camerony/VoronCustom/v0.1_KirigamiLDOStealthFront/README.md

# Kirigami LDO Steath Bed Front V0.1

Based on MapleLeafMakers https://github.com/MapleLeafMakers/Stealth_Bed_Front

Used the Stealthburner toolhead diffuser https://github.com/VoronDesign/Voron-Stealthburner/blob/main/STLs/Stealthburner/%5Bc%5D_stealthburner_LED_diffuser.stl

Works only with the LDO Neopixel PCB

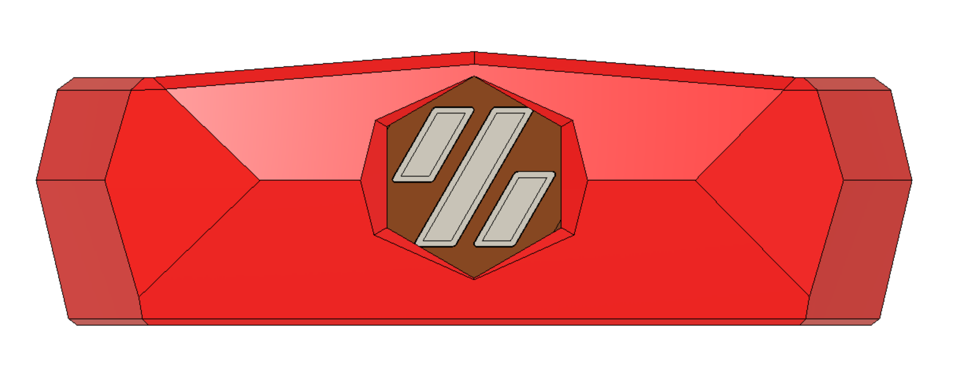
[picture p1: v0.1_KirigamiLDOStealthFront/images/front.png]
   
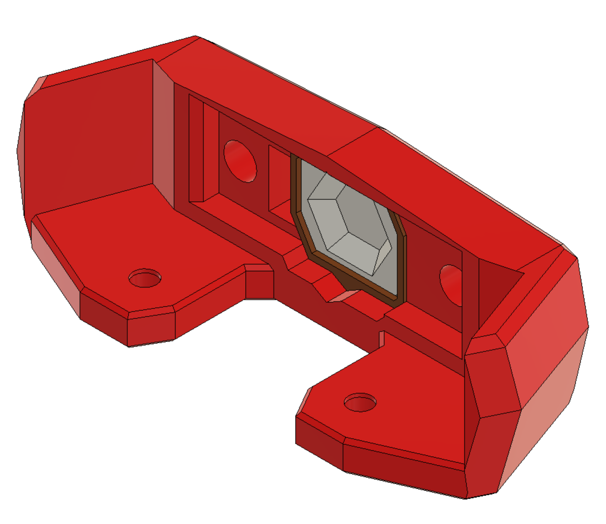
[picture p2: v0.1_KirigamiLDOStealthFront/images/back.png]
   

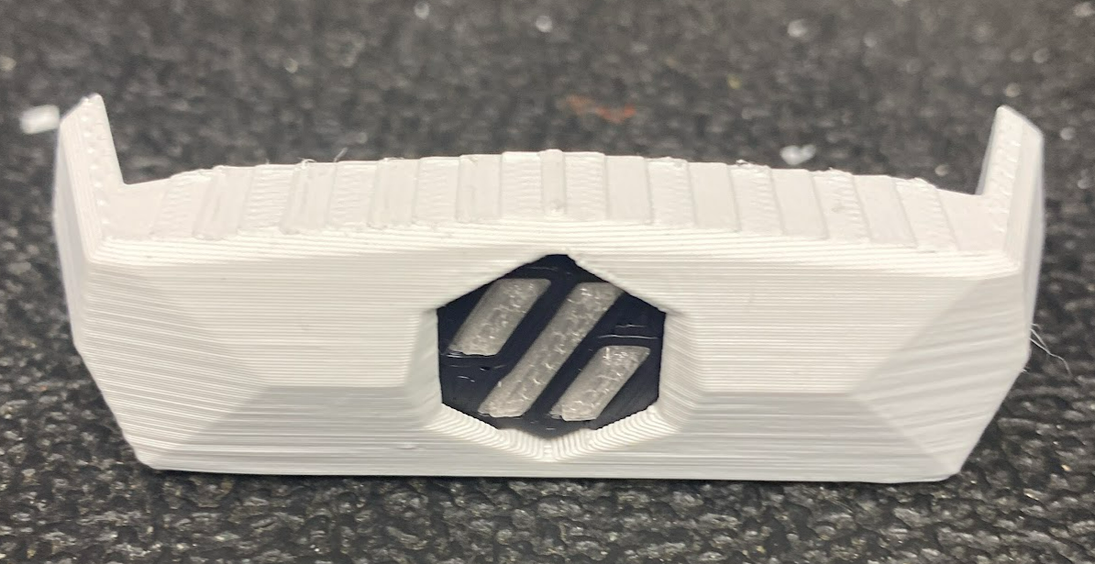
[picture p3: v0.1_KirigamiLDOStealthFront/images/print.png]
   
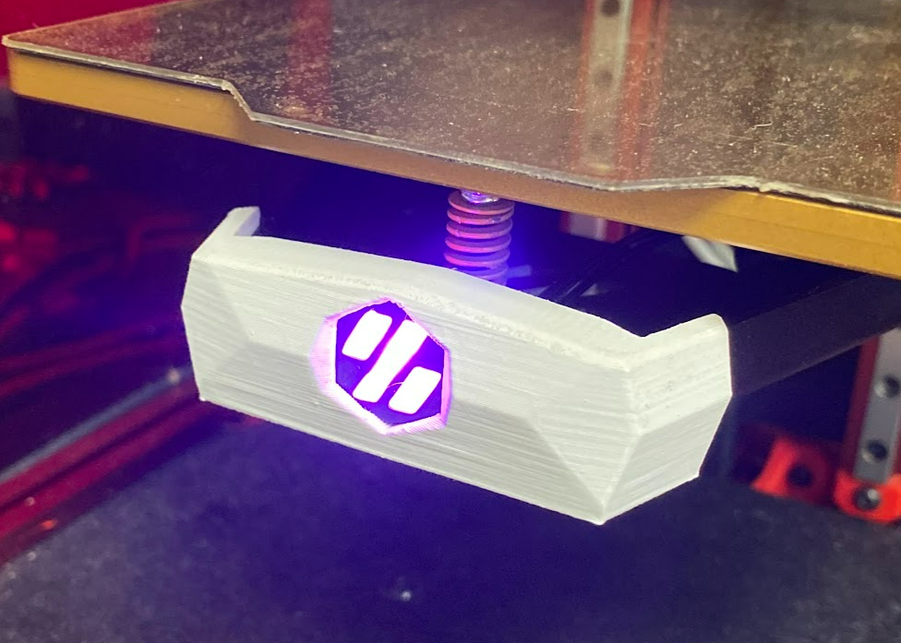
[picture p4: v0.1_KirigamiLDOStealthFront/images/installed.png]
