camerony/VoronCustom/v0.1_KirigamiCarriageSpacer/README.md

# Kirigami Bed Spacer V0.1

These spacers will allow you to reuse the original screws to mount the carriage to the Kirigami

8 x M2x8 SHCS

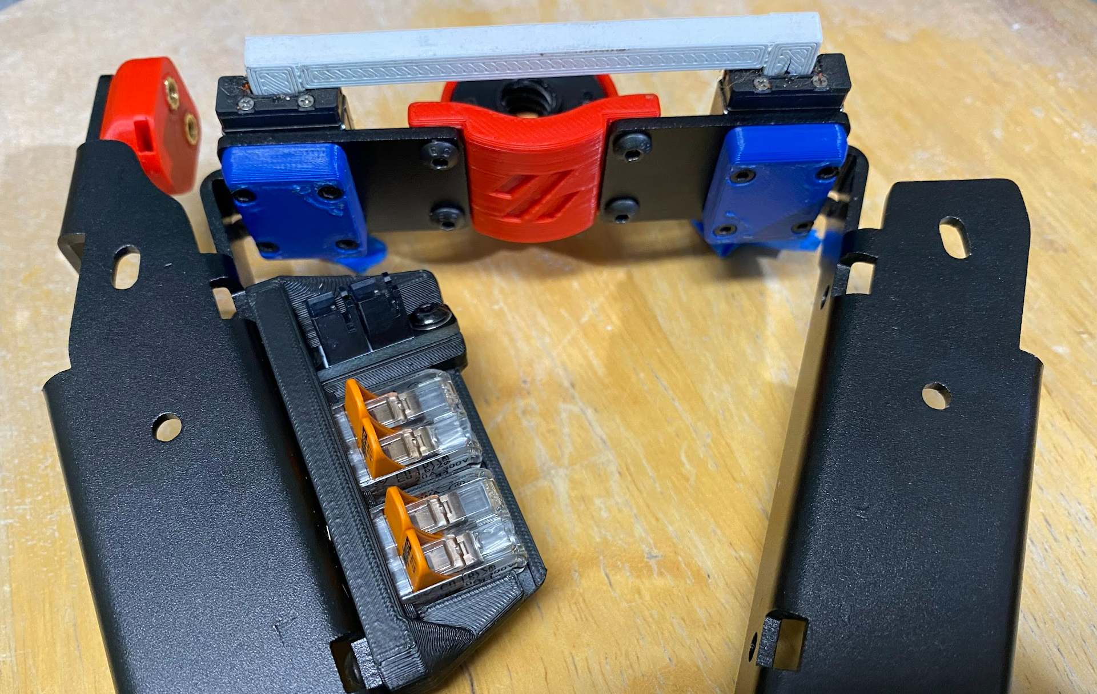
[picture p5: v0.1_KirigamiCarriageSpacer/images/installed.png]
