camerony/VoronCustom/V0.1_XY_Joint_Beefy/README.md

# XY Joint Extre Beef v0.1 (Beta)

.95mm of extra beef for the XY Joints

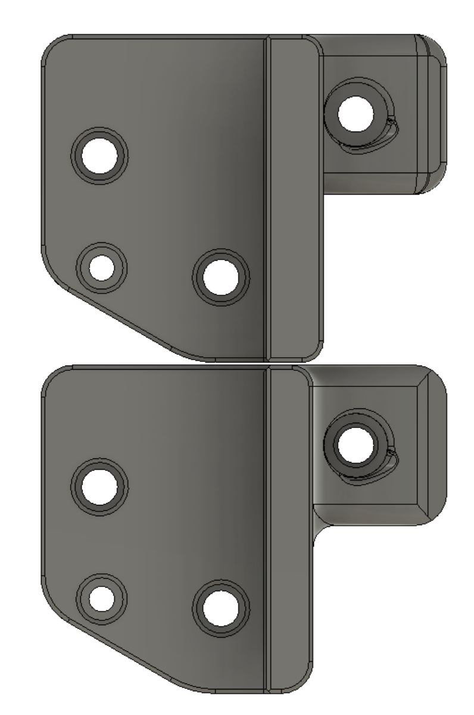
[picture p13: V0.1_XY_Joint_Beefy/images/cad.png]
