camerony/VoronCustom/v0.1_Tensioner_Knob_Indicator/README.md

# Tensioner Knob with Indicator v(Beta)

Makes it easier to get an even tension by having numbers on the tensioner knob.

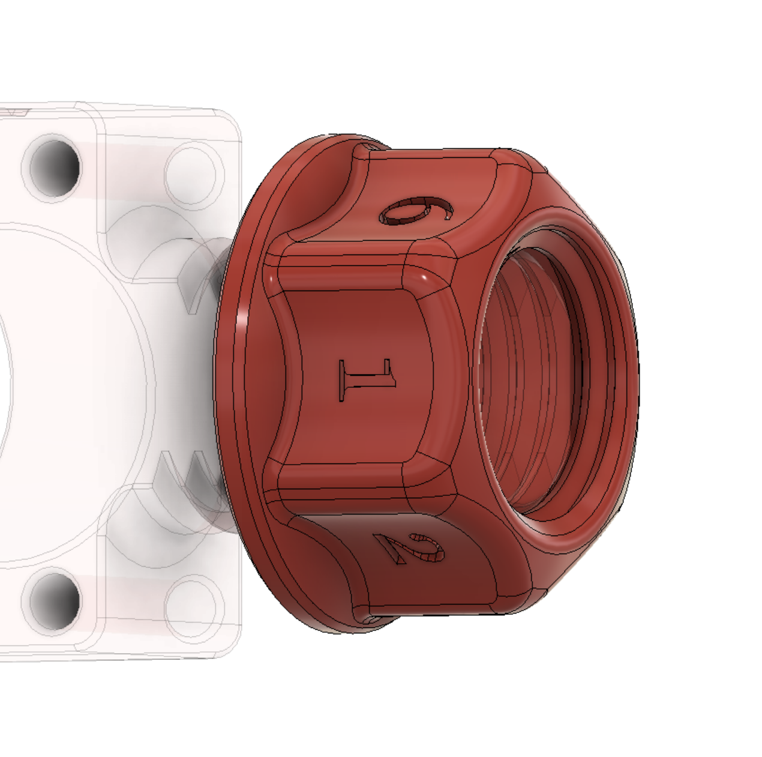
[picture p14: v0.1_Tensioner_Knob_Indicator/images/cad.png]
   
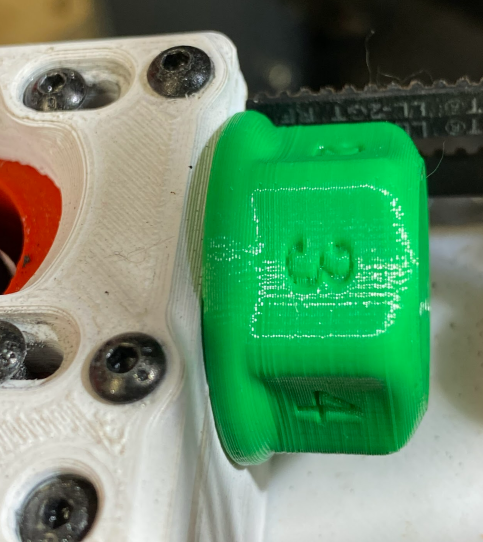
[picture p15: v0.1_Tensioner_Knob_Indicator/images/photo.png]
