camerony/VoronCustom/7x7CableChain/README.md

# 7x7 Cable Chain

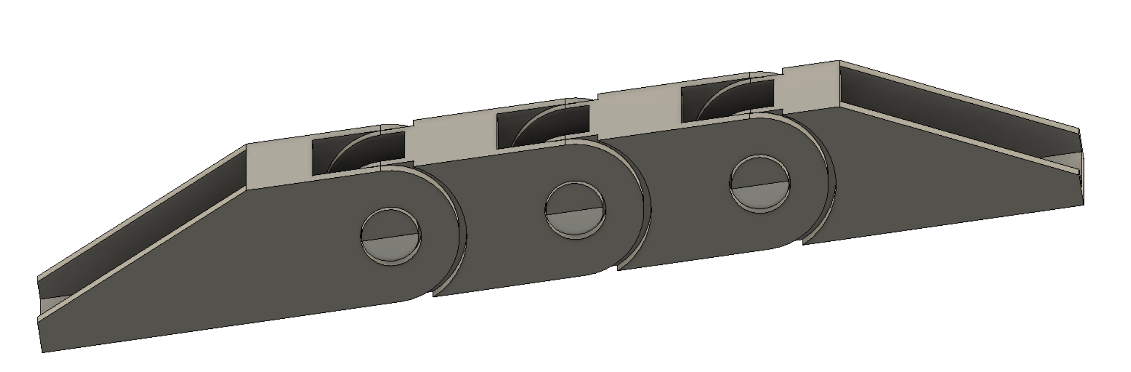
[picture p21: 7x7CableChain/images/cad.png]
   
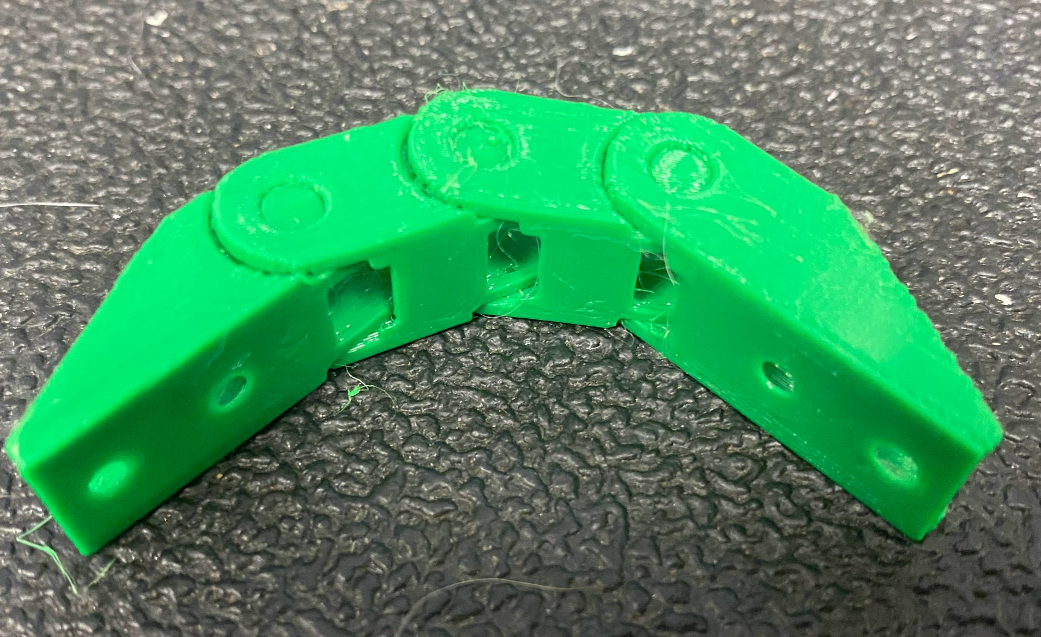
[picture p22: 7x7CableChain/images/photo.png]
   

Based on Cable Chain 7x7
by kespettakolo1973 https://www.thingiverse.com/thing:1867865
