camerony/VoronCustom/Plate_Nozzle_Probe/README.md

# Nozzy Probe : Plate Nozzle Probe for V0.1 (might work for others) ALPHA

MOVED TO V0.1_Nozzy_Probe
