camerony/VoronCustom/V0.1_Dual_X_Rail_Carriage/README.md

# Dual X Rail Carriage to V0.1

Add second rail to X-Axis to eliminate wobble

Requires:
1 x MGN7 rail (preferrable identical rail models)
4 x Machine Screw, FHCS, M2x6 (to attach carriage)
5 x M2x6 BHCS (mount rail to extrusion)
5 x M2 Nuts (mount rail to extrusion) or LDO rail mount

https://github.com/camerony/VoronCustom/blob/ebe7d462dfbc9d7f2f023d78ec90f3b2affd35e5/V0.1_Raise_X_Axis_Extrusion_by_4mm

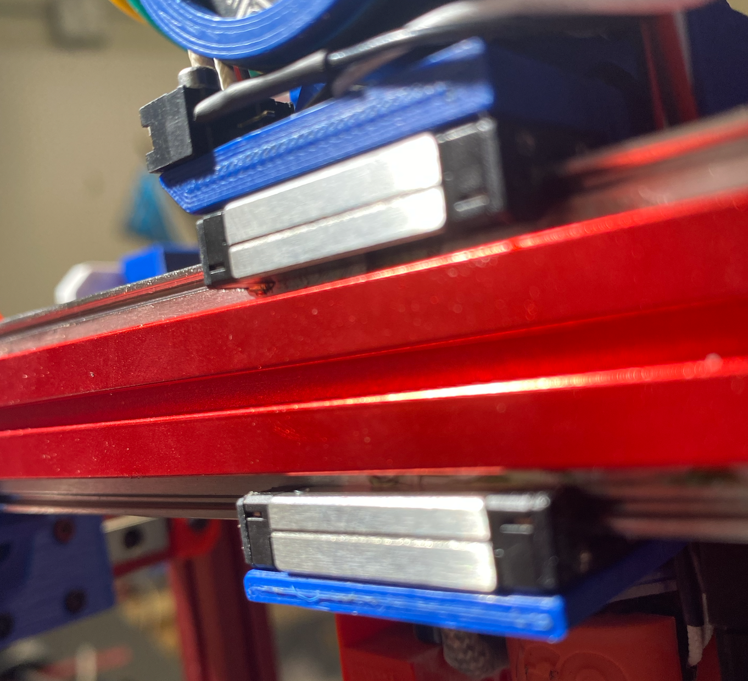
[picture p34: V0.1_Dual_X_Rail_Carriage/images/installed.png]

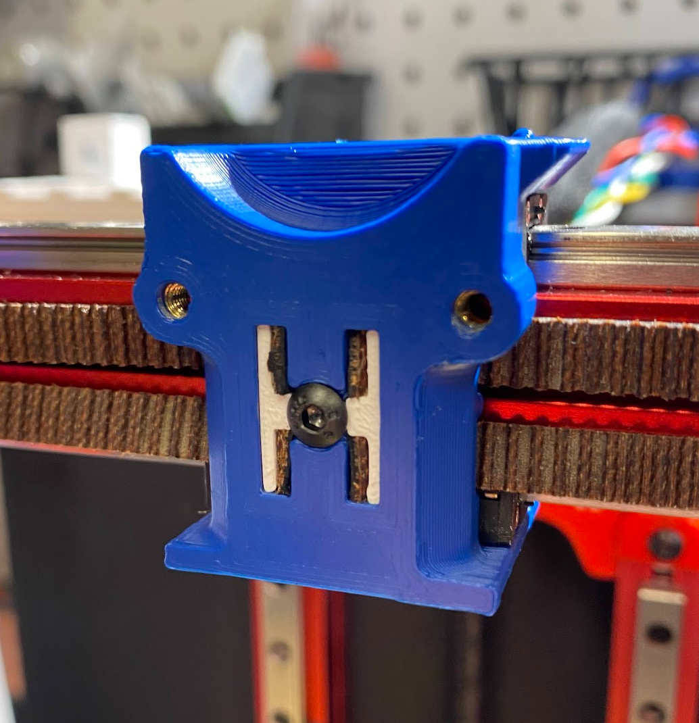
[picture p35: V0.1_Dual_X_Rail_Carriage/images/installeddualx.png]
