camerony/VoronCustom/V0.1_Raise_X_Axis_Extrusion_by_4mm/README.md

# Raise X-Axis Extrusion Clearance by 4mm

Adds 4mm clearance between X-Axis extrusion and Z-Axis extrusions.

Usage will allow for second X rail to be mounted underneath.

Notes: Toolhead offset will change by 4 mm.  The toolhead must be lowered by 4mm to maintain Z toolhead offset or bed travel has to be raised by 4mm

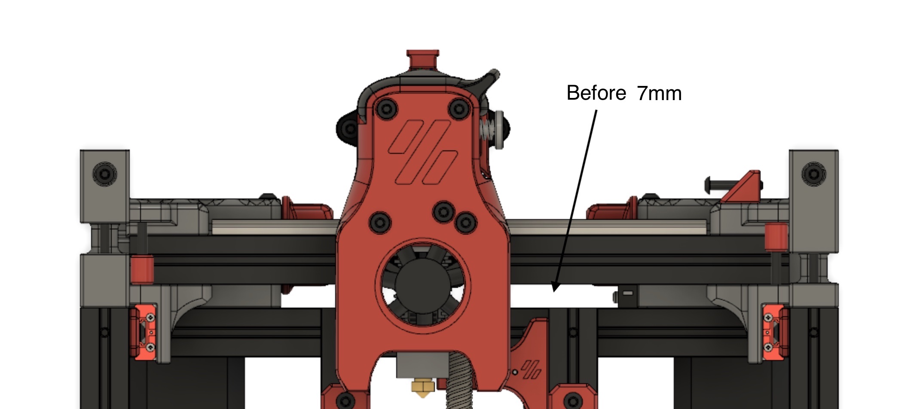
[picture p36: V0.1_Raise_X_Axis_Extrusion_by_4mm/images/before.jpg]

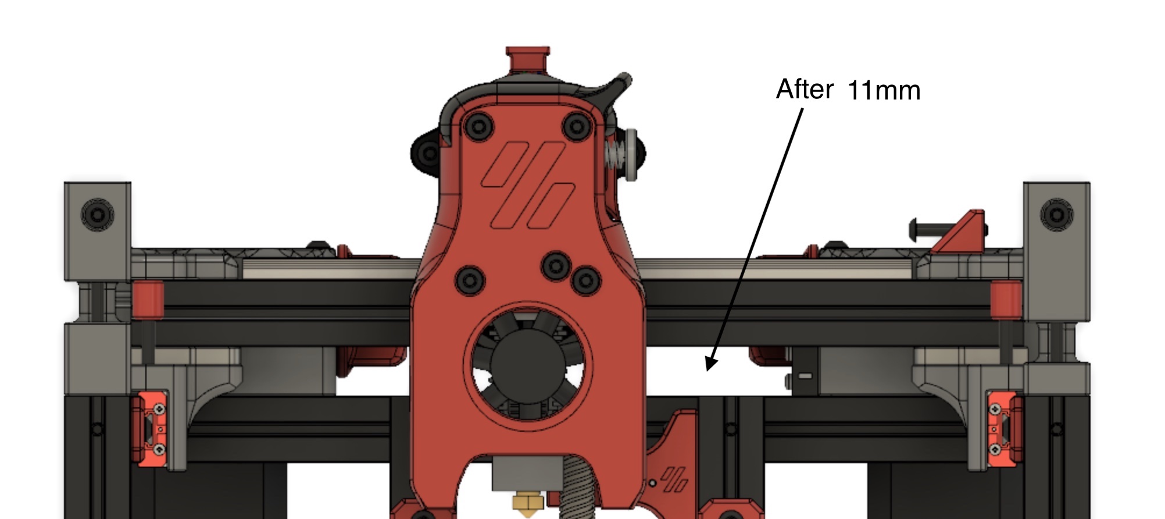
[picture p37: V0.1_Raise_X_Axis_Extrusion_by_4mm/images/after.jpg]
