camerony/VoronCustom/LDOSBCW2MountCover/images/IMG_20210709_141101.jpg

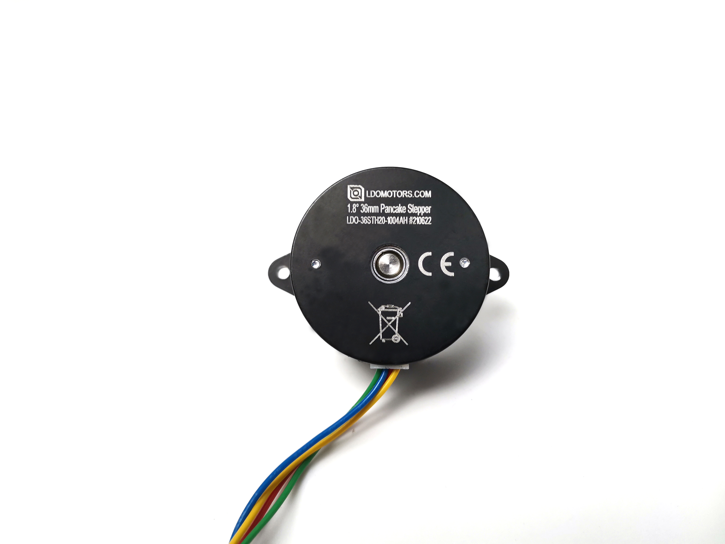
LDOSBCW2MountCover/images/IMG_20210709_141101.jpg
