camerony/VoronCustom/LDOSBCW2MountCover/images/LDO-36STH20-1004AHG(XH).png

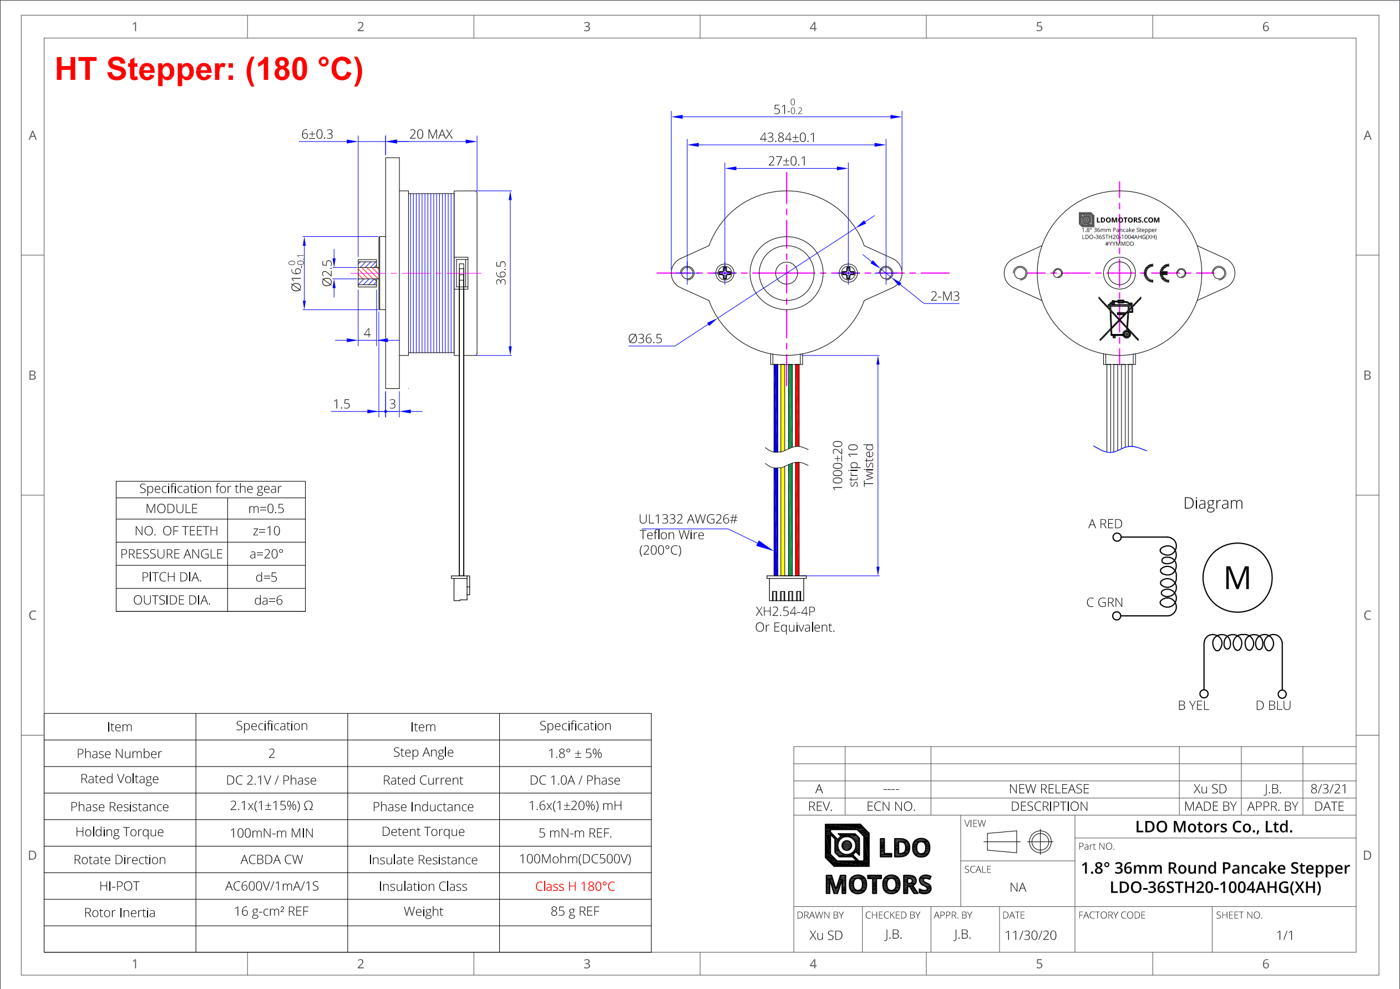
LDOSBCW2MountCover/images/LDO-36STH20-1004AHG(XH).png
