camerony/VoronCustom/LDOSBCW2MountCover/images/page1.png

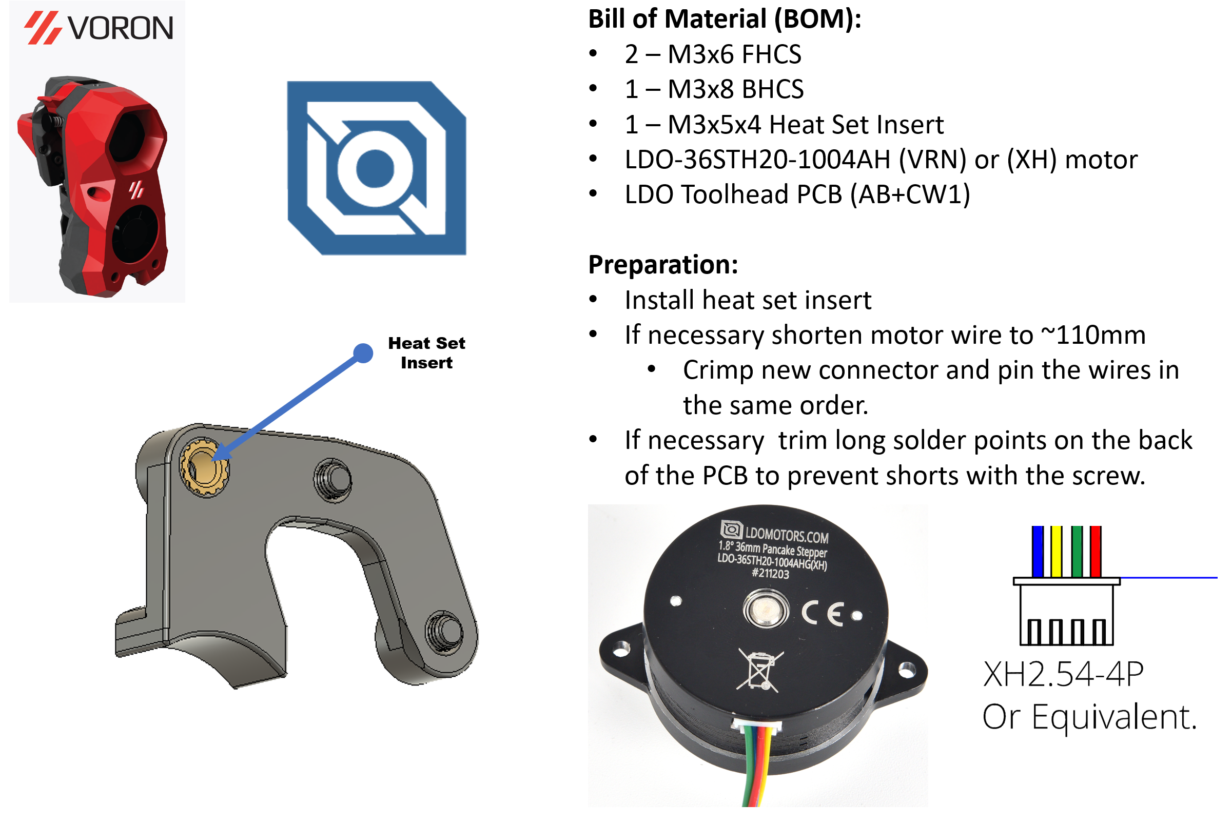
LDOSBCW2MountCover/images/page1.png
