camerony/VoronCustom/LDOSBCW2MountCover/images/SBCW2LDOPCB.png

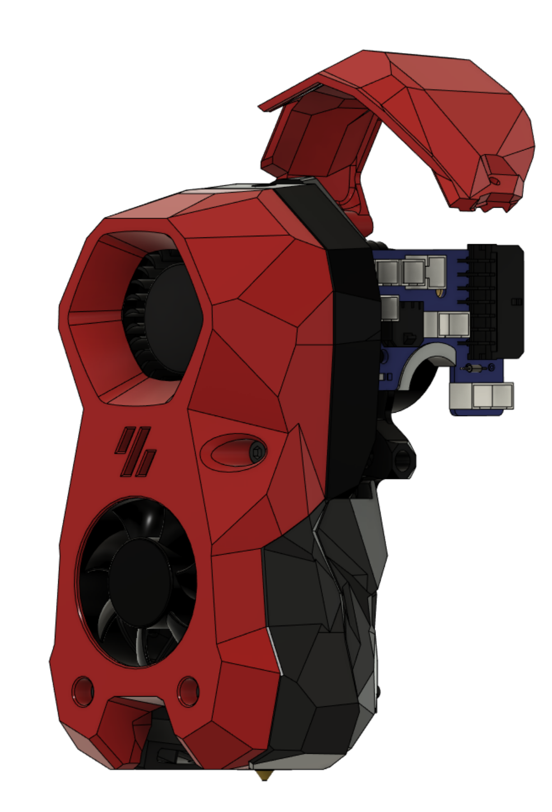
LDOSBCW2MountCover/images/SBCW2LDOPCB.png
