camerony/VoronCustom/V0.1_Display/images/cad2.png

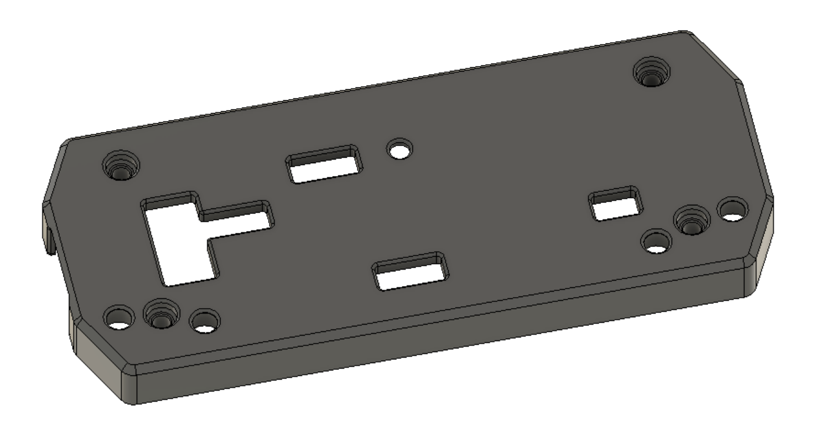
V0.1_Display/images/cad2.png
