camerony/VoronCustom/V0.1_Display/images/cad.png

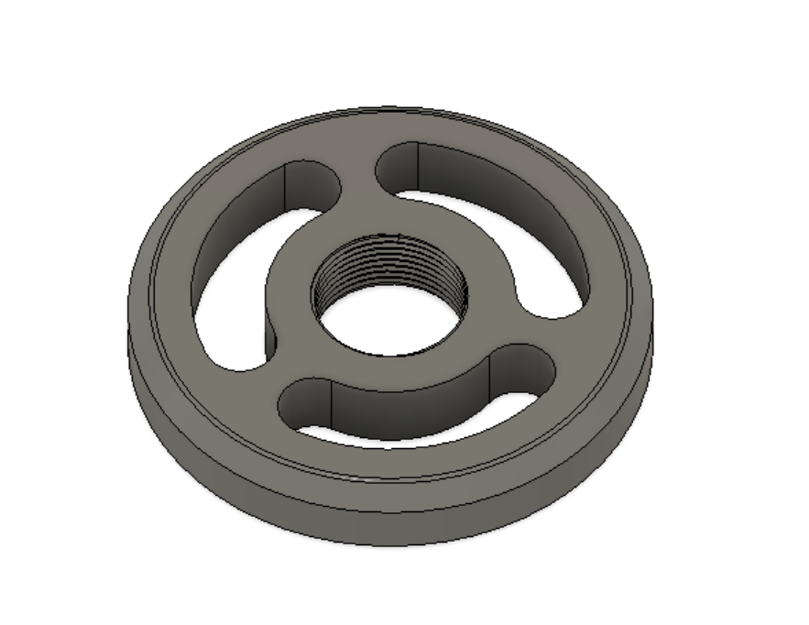
V0.1_Display/images/cad.png
