camerony/VoronCustom/V0.1_NoNut_X_Carriage/images/nut.png

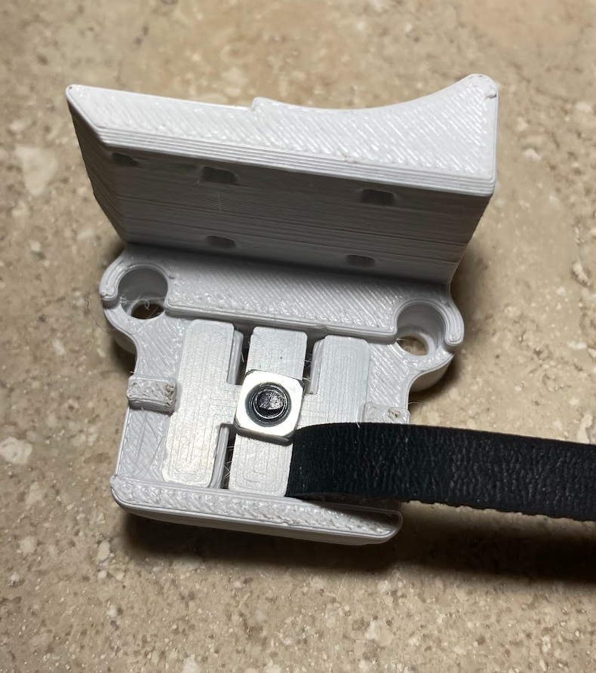
V0.1_NoNut_X_Carriage/images/nut.png
