camerony/VoronCustom/LDOPanels/LDODeckPanelFull.3mf

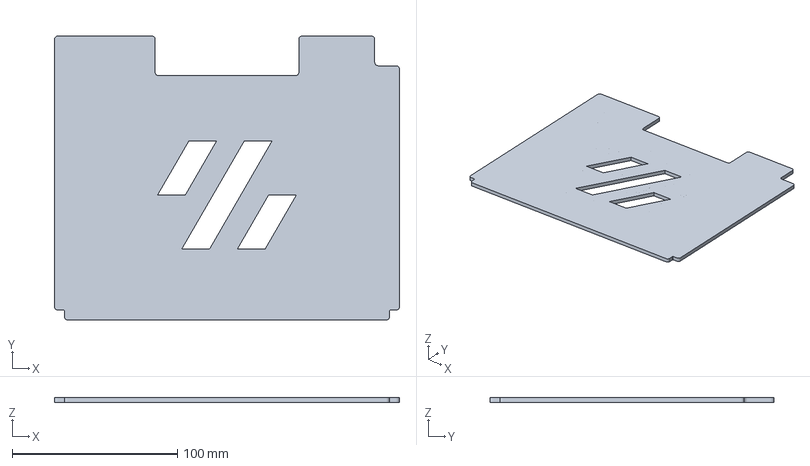
[picture p48: CAD file, 2022-01-04]
LDOPanels/LDODeckPanelFull.3mf
209.0 x 172.0 x 3.00 mm
