camerony/VoronCustom/3mmIdlers/3mmIdlers.stl

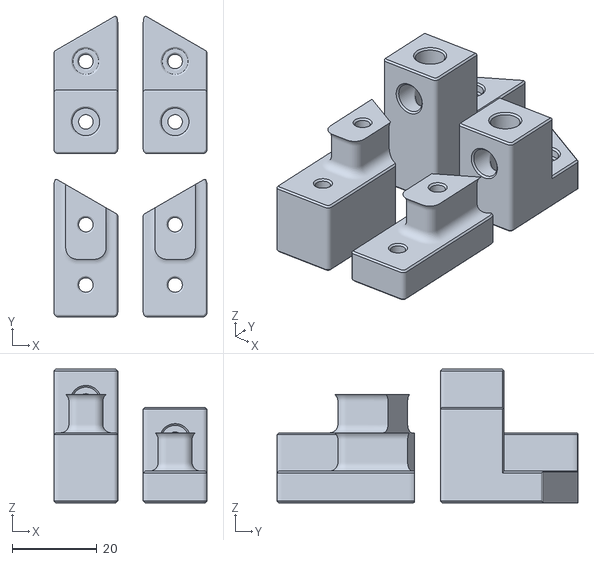
[picture p49: CAD file, 2022-01-26]
3mmIdlers/3mmIdlers.stl
36.0 x 70.8 x 31.5
