camerony/VoronCustom/7x7CableChain/7x7cablechain.step

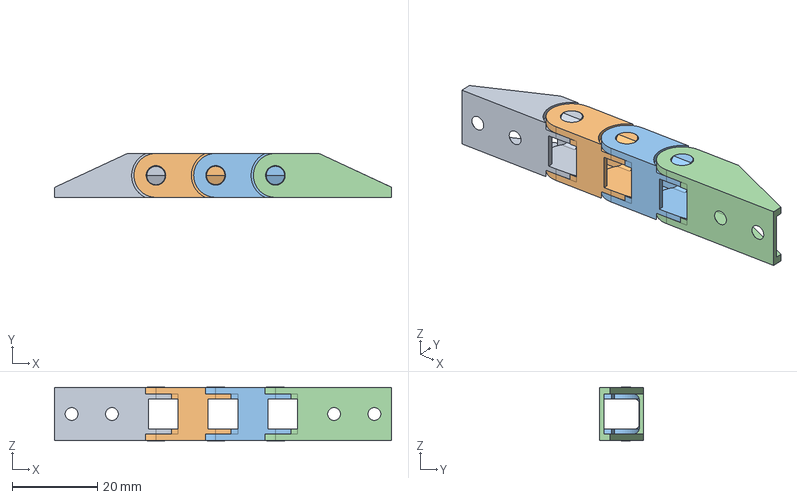
[picture p50: CAD file, 2022-03-20]
7x7CableChain/7x7cablechain.step
79.0 x 10.3 x 12.6 mm
7x7_end_male
7x7_cable_chain
7x7_cable_chain (1)
7x7_end_female
