camerony/VoronCustom/LDOPanels/LDOBackPanel.3mf

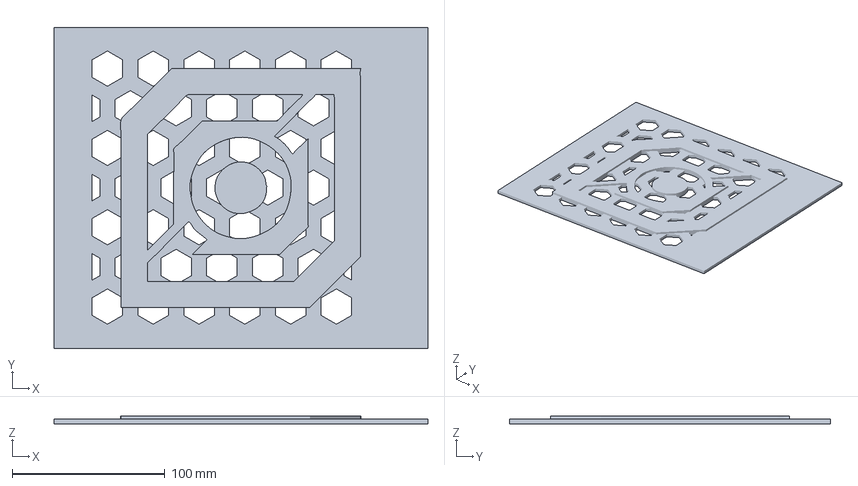
[picture p51: CAD file, 2022-01-04]
LDOPanels/LDOBackPanel.3mf
245.0 x 210.0 x 5.00 mm
