camerony/VoronCustom/LDOSBCW2MountCover/LDOSBCW2MountCover.3mf

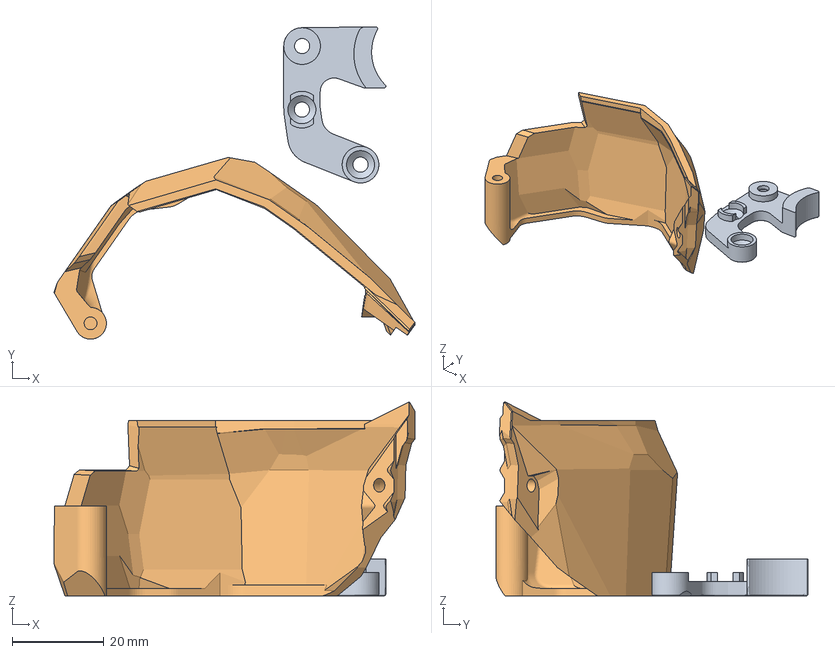
[picture p52: CAD file, 2022-08-19]
LDOSBCW2MountCover/LDOSBCW2MountCover.3mf
78.6 x 68.0 x 42.2 mm
