camerony/VoronCustom/LDOStrainRelief/VORON_CAD_V0.1_Strain_Relief_LDO_spacer_x2.3mf

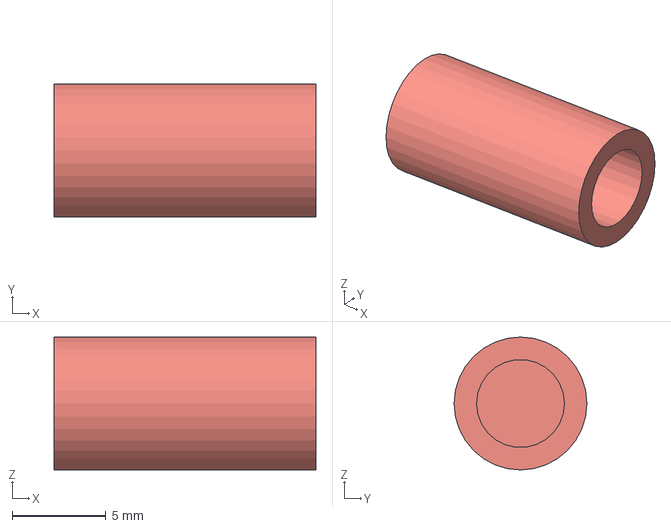
[picture p53: CAD file, 2021-11-27]
LDOStrainRelief/VORON_CAD_V0.1_Strain_Relief_LDO_spacer_x2.3mf
14.0 x 7.10 x 7.10 mm
