camerony/VoronCustom/MiniASLGXerpaLiteMount/MiniASLGXerpaLite-CoverV2.step

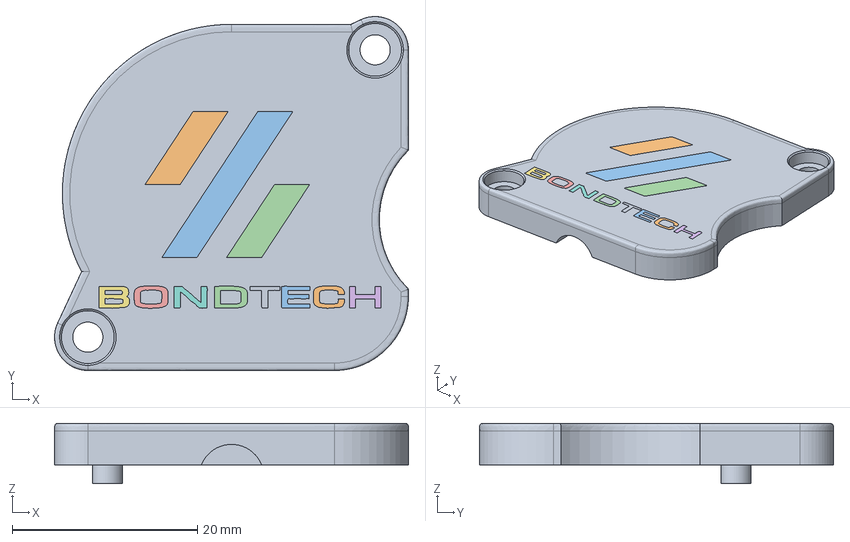
[picture p54: CAD file, 2022-03-21]
MiniASLGXerpaLiteMount/MiniASLGXerpaLite-CoverV2.step
38.2 x 38.2 x 6.50 mm
