camerony/VoronCustom/NeoPixelSolderingTool/NeoPixelSolderingTool.step

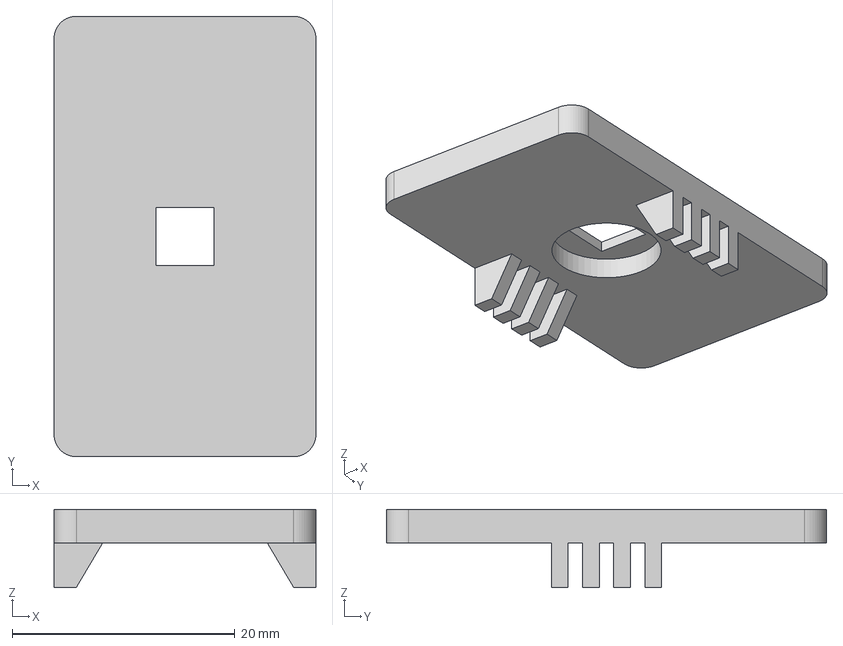
[picture p55: CAD file, 2022-04-14]
NeoPixelSolderingTool/NeoPixelSolderingTool.step
23.5 x 39.5 x 7.00 mm
