camerony/VoronCustom/Tuning/BeltTensionEqualizer/BeltTensionEqualizer.3mf

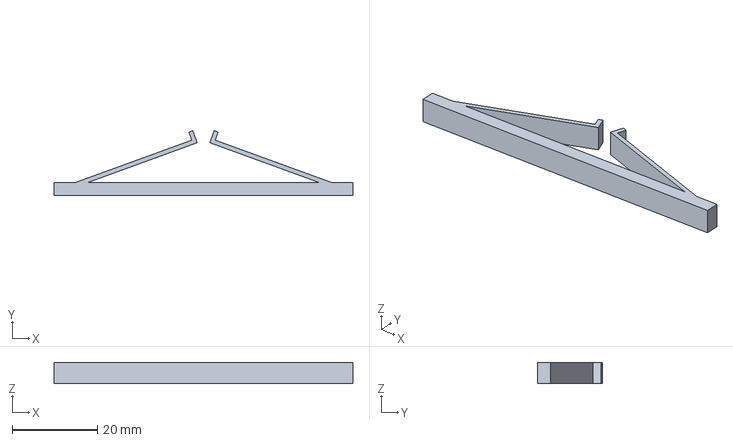
[picture p56: CAD file, 2022-01-04]
Tuning/BeltTensionEqualizer/BeltTensionEqualizer.3mf
70.0 x 15.1 x 5.00 mm
