camerony/VoronCustom/Tuning/VFA/VFA_Model_SS_Thick.3mf

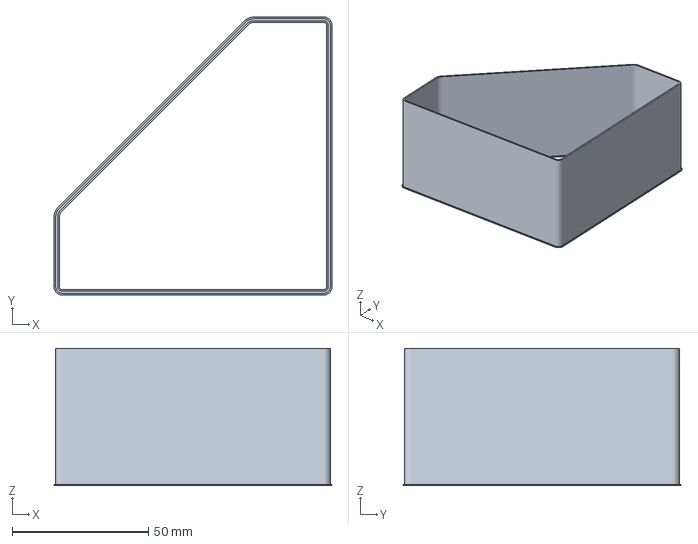
[picture p57: CAD file, 2022-03-28]
Tuning/VFA/VFA_Model_SS_Thick.3mf
102.0 x 102.0 x 50.3 mm
