camerony/VoronCustom/V0.1_BedTransfer/V0.1_bed_transfer.step

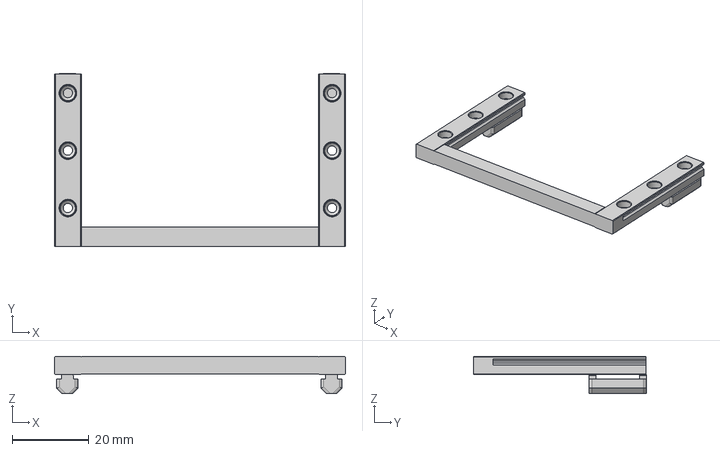
[picture p58: CAD file, 2022-03-06]
V0.1_BedTransfer/V0.1_bed_transfer.step
76.0 x 45.1 x 9.79 mm
