camerony/VoronCustom/V0.1_Display/Housing_Rear_M2_10_x1.step

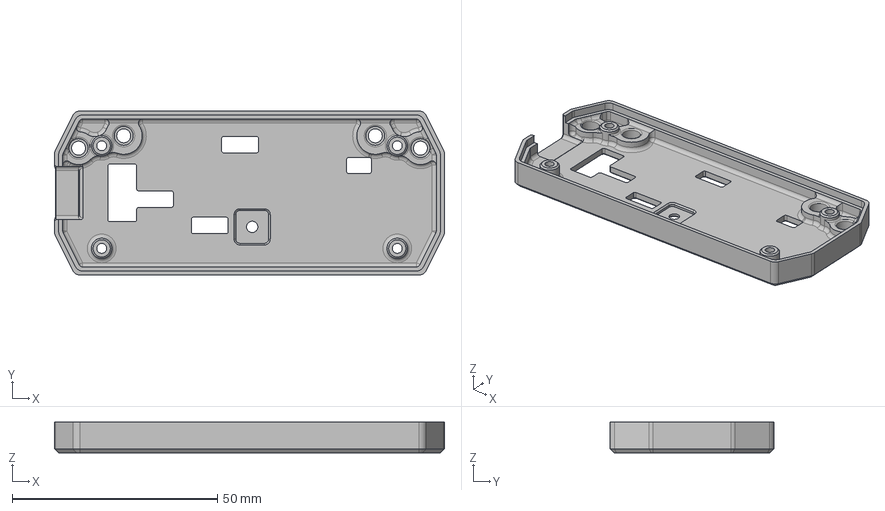
[picture p59: CAD file, 2022-04-21]
V0.1_Display/Housing_Rear_M2_10_x1.step
95.0 x 40.0 x 7.50 mm
