camerony/VoronCustom/V0.1_Dual_X_Rail_Carriage/standard_dual_x_carriage.stl

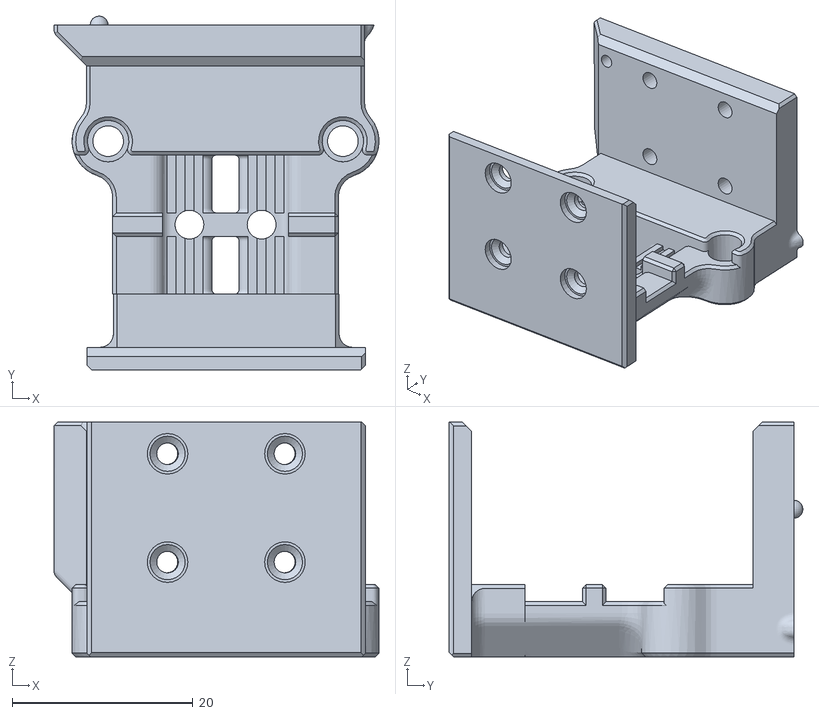
[picture p60: CAD file, 2022-01-28]
V0.1_Dual_X_Rail_Carriage/standard_dual_x_carriage.stl
36.0 x 39.2 x 26.0
