camerony/VoronCustom/v0.1_KirigamiCarriageSpacer/KirigamiCarriageSpacer_x2.3mf

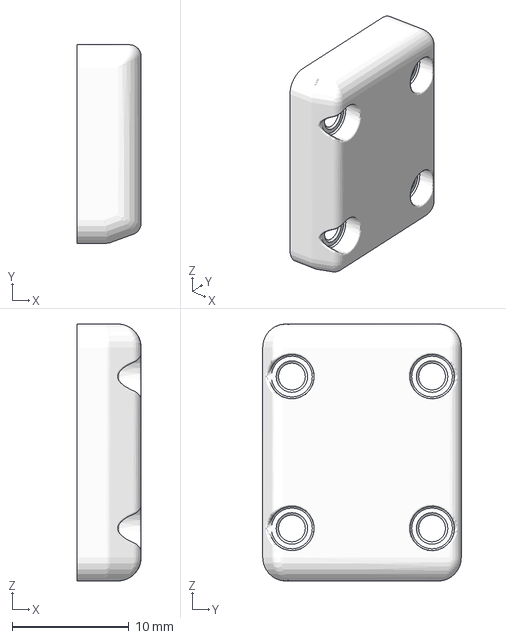
[picture p61: CAD file, 2022-05-16]
v0.1_KirigamiCarriageSpacer/KirigamiCarriageSpacer_x2.3mf
5.50 x 17.0 x 22.0 mm
