camerony/VoronCustom/v0.1_KirigamiLDOStealthFront/b_NeoPixel_Diffuser_Mask.stl

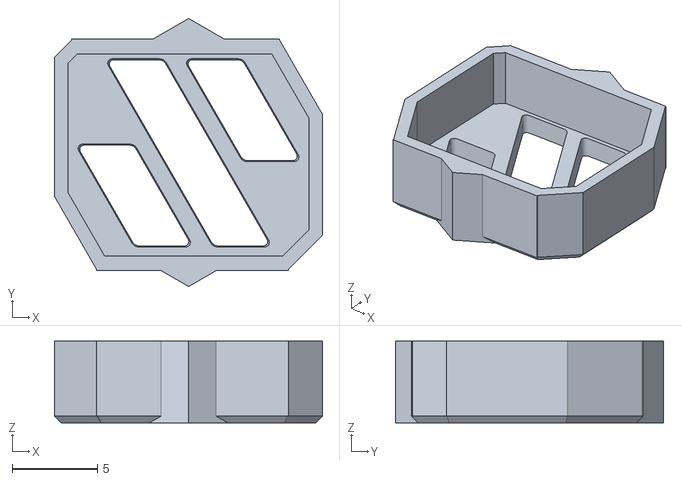
[picture p62: CAD file, 2022-09-03]
v0.1_KirigamiLDOStealthFront/b_NeoPixel_Diffuser_Mask.stl
15.7 x 15.7 x 4.80
