camerony/VoronCustom/v0.1_MiniAfterBlockHead/V2/hotendmountsV2/rapido_a.3mf

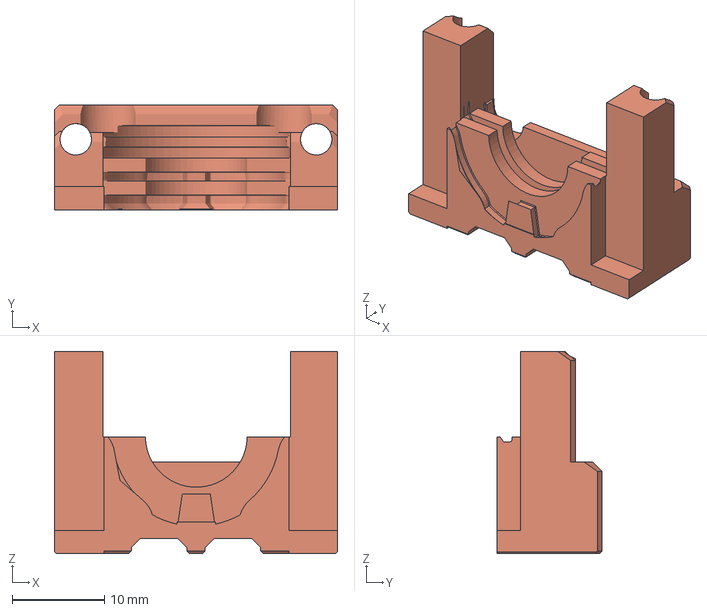
[picture p63: CAD file, 2022-04-21]
v0.1_MiniAfterBlockHead/V2/hotendmountsV2/rapido_a.3mf
30.6 x 11.4 x 21.9 mm
