camerony/VoronCustom/v0.1_MiniAfterBlockHead/V2/V01_MiniAfterBlockheadV2.3mf

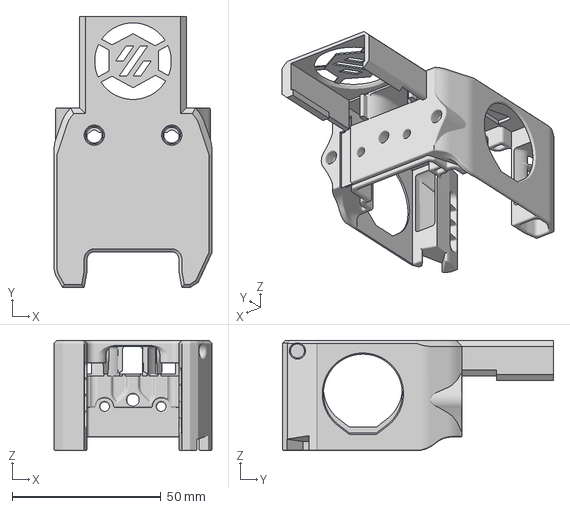
[picture p64: CAD file, 2022-04-21]
v0.1_MiniAfterBlockHead/V2/V01_MiniAfterBlockheadV2.3mf
53.0 x 91.0 x 37.0 mm
