camerony/VoronCustom/v0.1_MiniAfterBlockHead/X_Carriage_MGN9.step

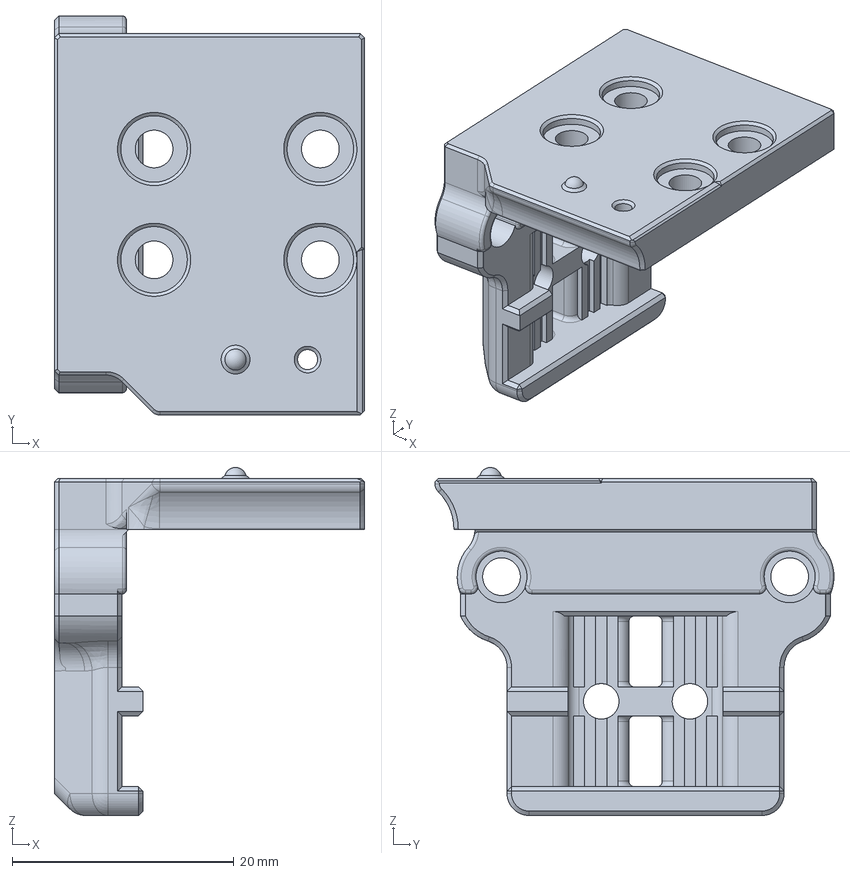
[picture p65: CAD file, 2022-03-29]
v0.1_MiniAfterBlockHead/X_Carriage_MGN9.step
28.0 x 36.0 x 31.4 mm
