camerony/VoronCustom/v0.1_MiniAfterHybrid/Orbiter2Mount.step

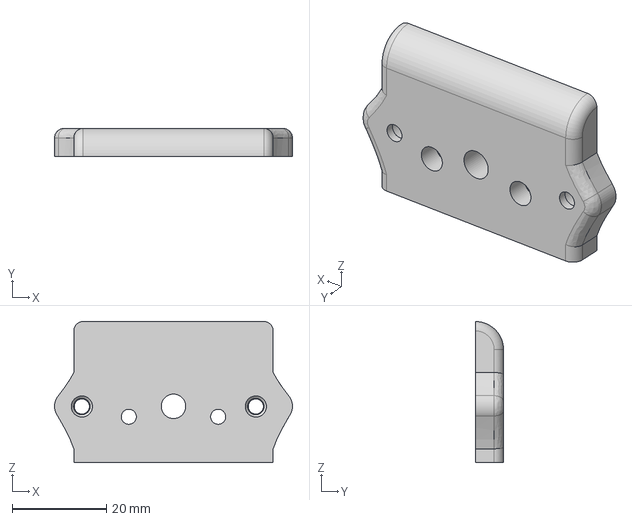
[picture p66: CAD file, 2022-04-02]
v0.1_MiniAfterHybrid/Orbiter2Mount.step
50.6 x 6.00 x 30.0 mm
