camerony/VoronCustom/V0.1_NoNut_X_Carriage/nonut_x_carriage_belt_guide_x1.stl

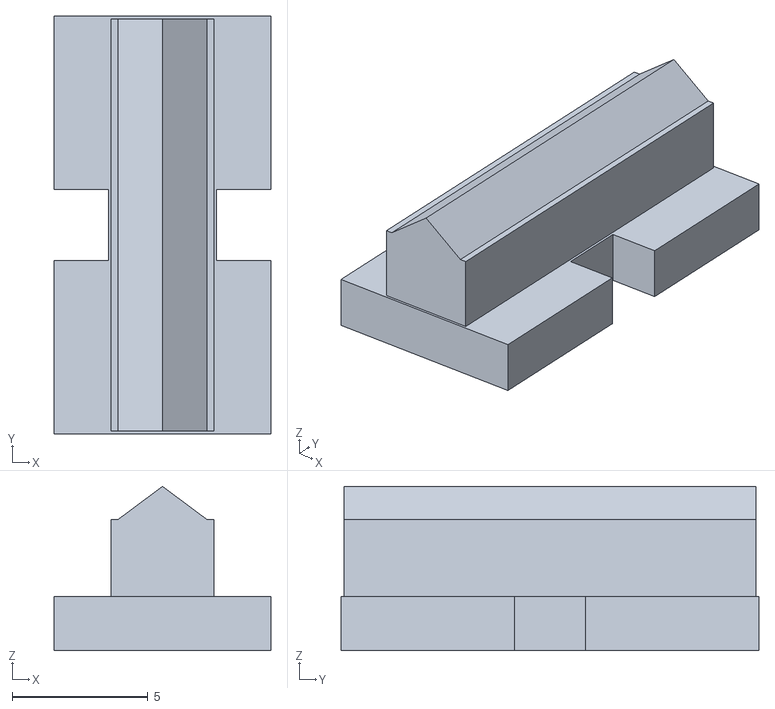
[picture p67: CAD file, 2022-01-22]
V0.1_NoNut_X_Carriage/nonut_x_carriage_belt_guide_x1.stl
8.00 x 15.4 x 6.05
