camerony/VoronCustom/V0.1_Raise_X_Axis_Extrusion_by_4mm/XY_Joint_Left_Mid_Raised4mm_x1.stl

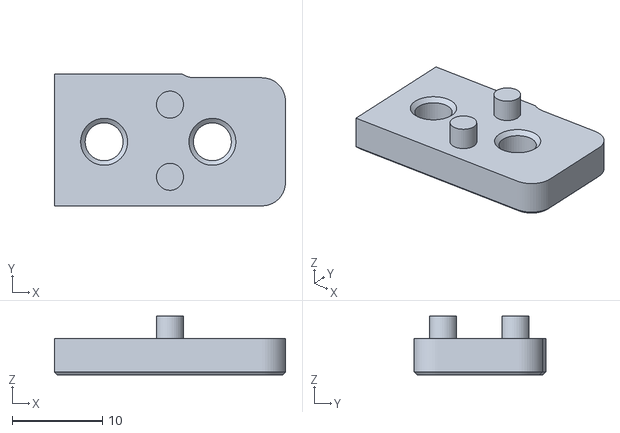
[picture p68: CAD file, 2022-01-16]
V0.1_Raise_X_Axis_Extrusion_by_4mm/XY_Joint_Left_Mid_Raised4mm_x1.stl
25.6 x 14.6 x 6.50
