camerony/VoronCustom/v0.1_Tensioner_Knob_Indicator/Tensioner_Knob_Marks.step

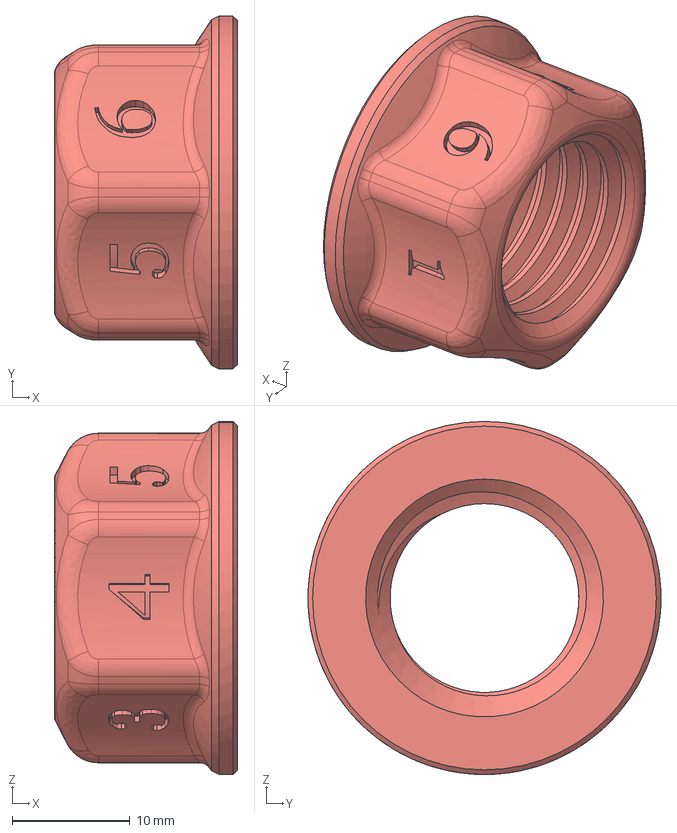
[picture p69: CAD file, 2022-03-22]
v0.1_Tensioner_Knob_Indicator/Tensioner_Knob_Marks.step
15.6 x 30.0 x 30.0 mm
