camerony/VoronCustom/V0.1_XY_Joint_Beefy/XY_Joint_Right_Beefy_Lower_x1.step

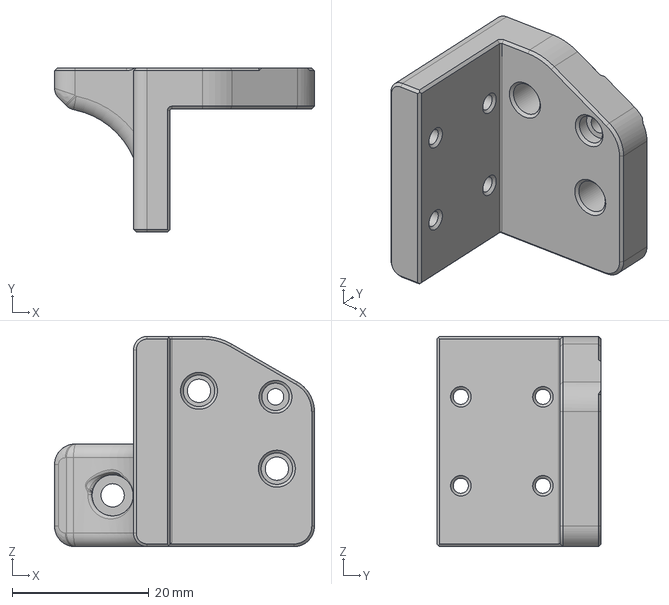
[picture p70: CAD file, 2022-03-26]
V0.1_XY_Joint_Beefy/XY_Joint_Right_Beefy_Lower_x1.step
38.0 x 24.0 x 30.7 mm
