camerony/VoronCustom/V0.1_Z_Chain_Mount/V01_Z_Chain_Mount.step

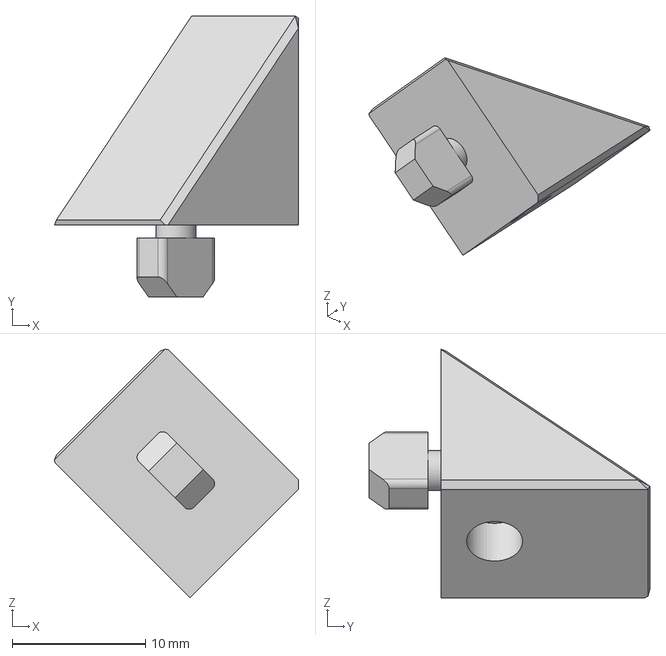
[picture p71: CAD file, 2022-03-10]
V0.1_Z_Chain_Mount/V01_Z_Chain_Mount.step
18.3 x 21.0 x 18.6 mm
