camerony/VoronCustom/V0.1_Z_Jiggy/V01_Z_Jiggy.step

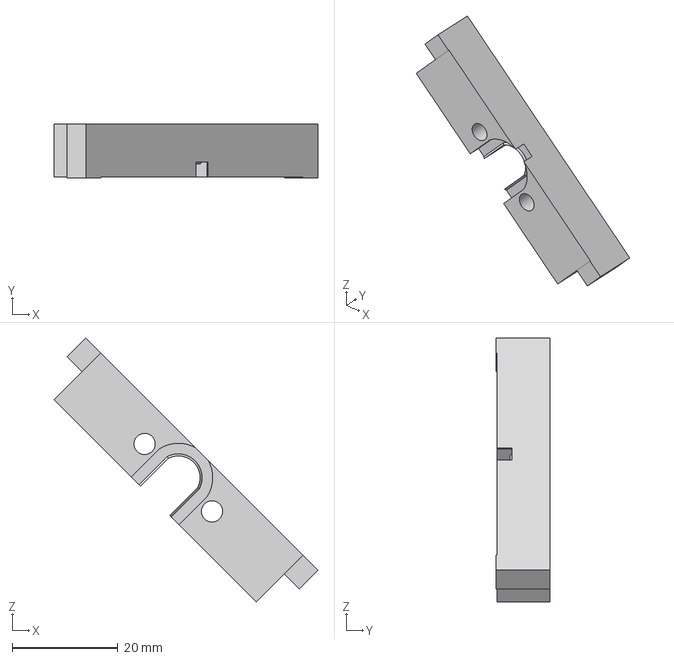
[picture p72: CAD file, 2022-03-18]
V0.1_Z_Jiggy/V01_Z_Jiggy.step
49.9 x 10.1 x 49.9 mm
