camerony/VoronCustom/LDOSBCW2MountCover/LDOSBCW2Cover.step

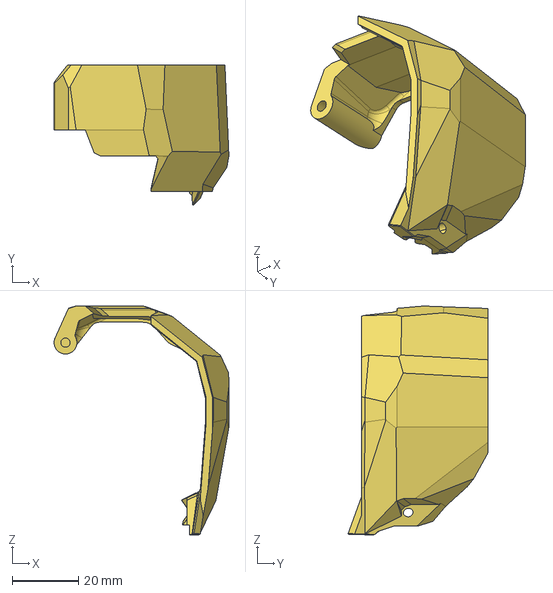
[picture p73: CAD file, 2022-08-19]
LDOSBCW2MountCover/LDOSBCW2Cover.step
52.8 x 42.2 x 69.1 mm
