camerony/VoronCustom/LDOStrainRelief/VORON_CAD_V0.1_Strain_Relief_LDO_x1.3mf

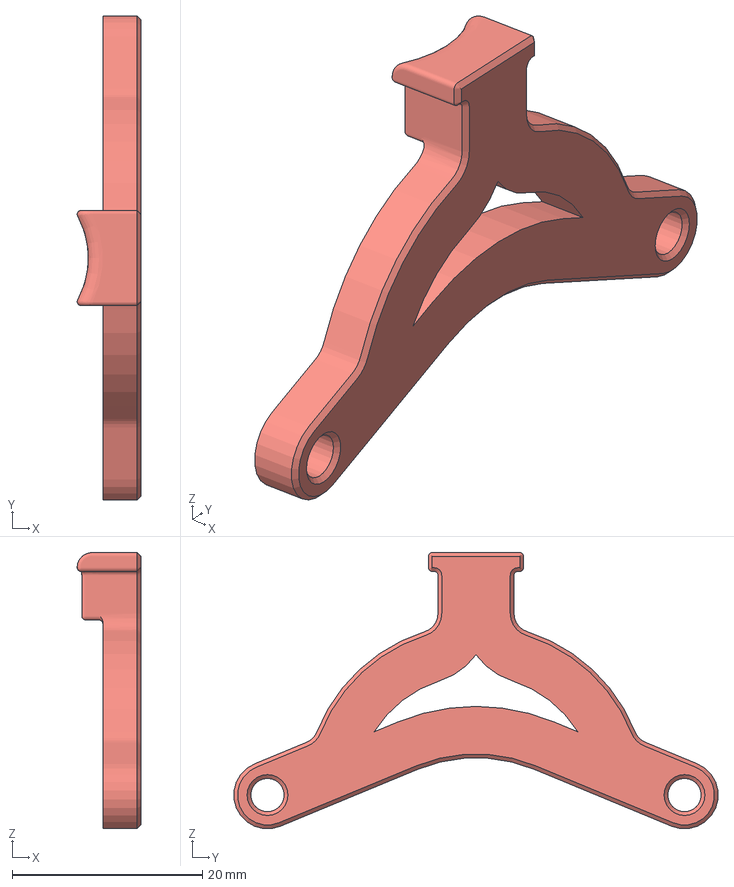
[picture p74: CAD file, 2021-11-27]
LDOStrainRelief/VORON_CAD_V0.1_Strain_Relief_LDO_x1.3mf
6.69 x 50.9 x 29.0 mm
