camerony/VoronCustom/V0.1_Display/[a]_Knob_Spacer_x1.step

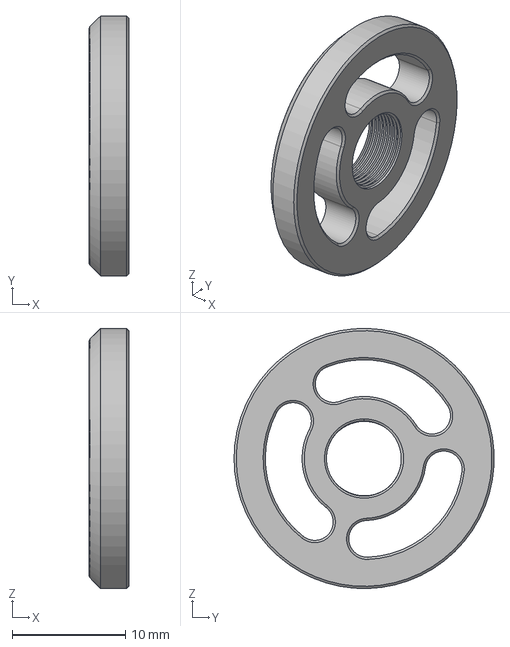
[picture p75: CAD file, 2022-04-21]
V0.1_Display/[a]_Knob_Spacer_x1.step
3.50 x 23.0 x 23.0 mm
