camerony/VoronCustom/v0.1_KirigamiLDOStealthFront/LDO_Stealth_Bed_Front.step

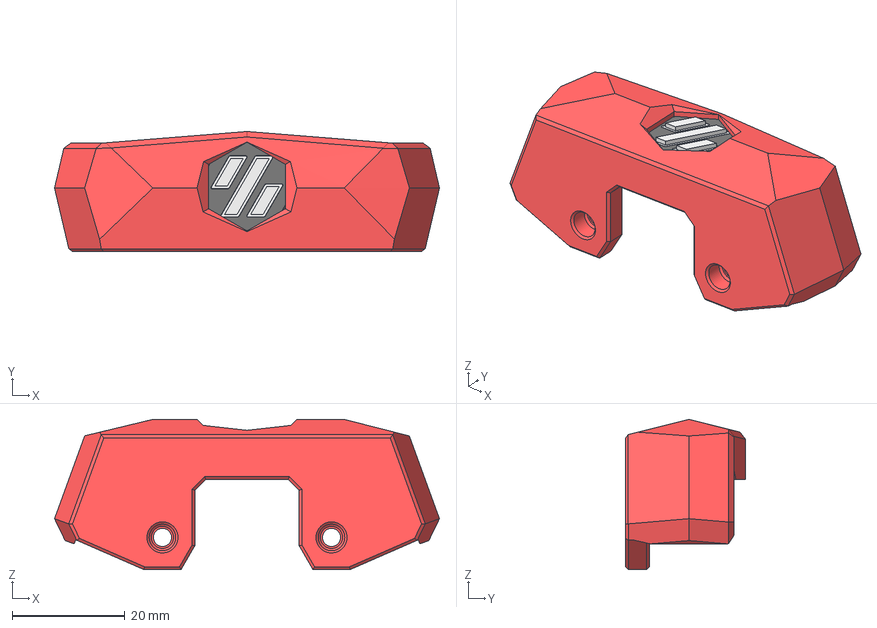
[picture p76: CAD file, 2022-09-03]
v0.1_KirigamiLDOStealthFront/LDO_Stealth_Bed_Front.step
68.2 x 21.3 x 26.6 mm
MainBody (1)
led_diffuser (1)
led_diffuser_mask (1)
