camerony/VoronCustom/v0.1_MiniAfterBlockHead/V2/hotendmountsV2/rapido_b.3mf

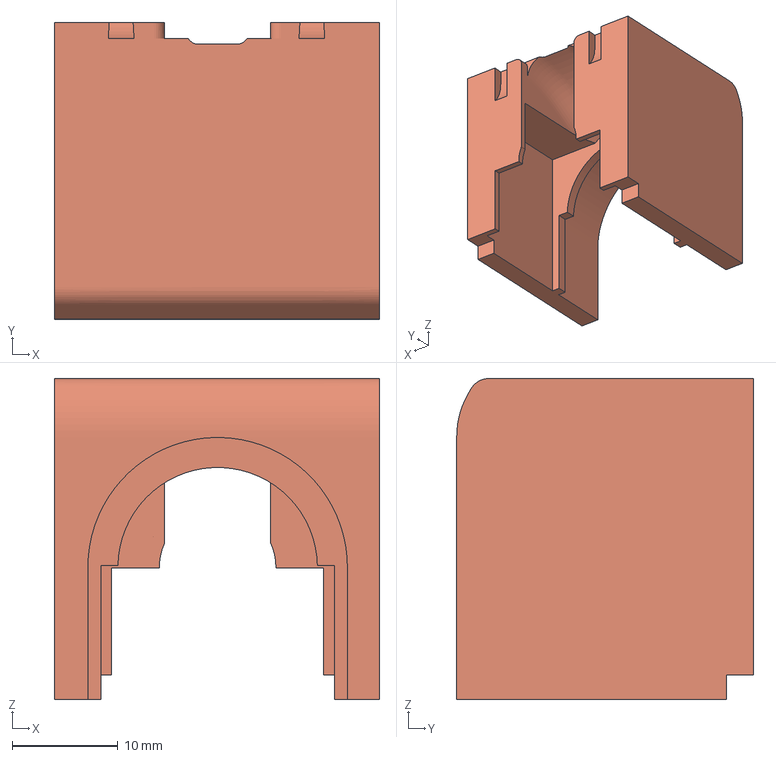
[picture p77: CAD file, 2022-04-21]
v0.1_MiniAfterBlockHead/V2/hotendmountsV2/rapido_b.3mf
30.7 x 28.0 x 30.3 mm
