camerony/VoronCustom/v0.1_MiniAfterHybrid/V01_MountRevoMicro.3mf

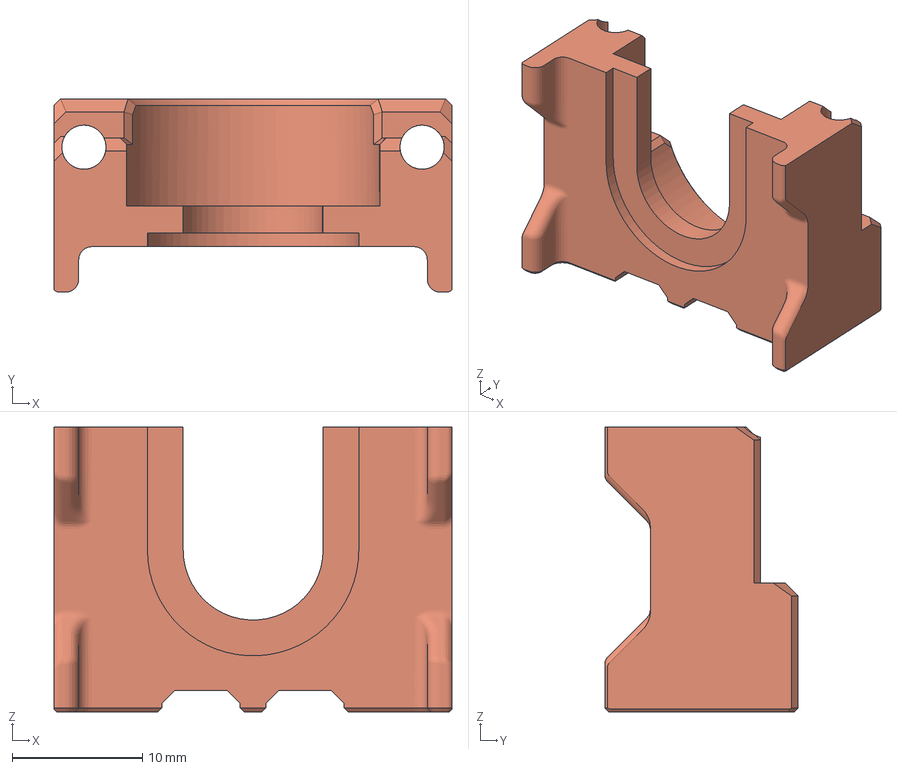
[picture p78: CAD file, 2022-03-31]
v0.1_MiniAfterHybrid/V01_MountRevoMicro.3mf
30.6 x 14.9 x 21.9 mm
