camerony/VoronCustom/V0.1_NoNut_X_Carriage/nonut_x_carriage_removal_tool_x1.stl

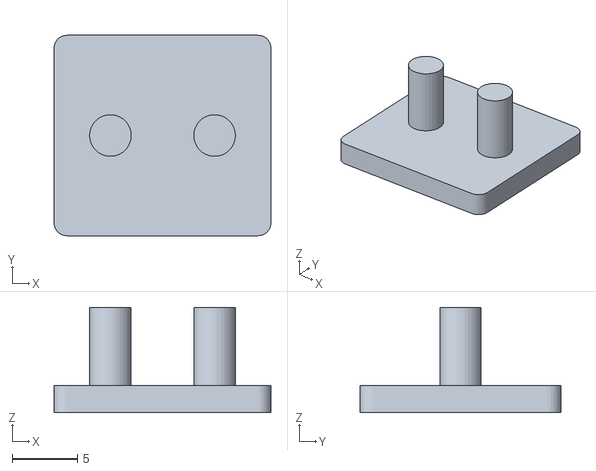
[picture p79: CAD file, 2022-01-22]
V0.1_NoNut_X_Carriage/nonut_x_carriage_removal_tool_x1.stl
16.7 x 15.4 x 8.10
