camerony/VoronCustom/LDOPanels/BackPanel.3mf

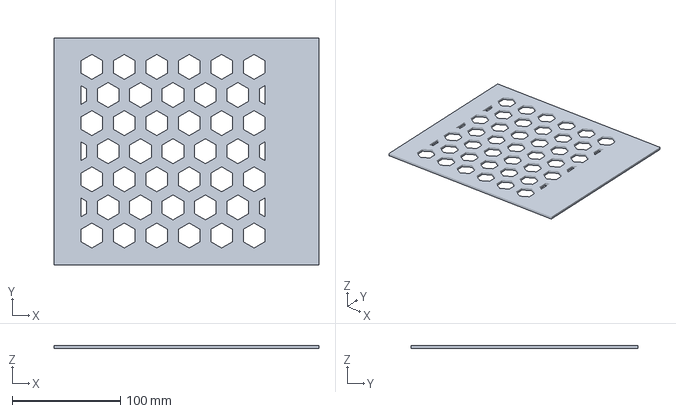
[picture p80: CAD file, 2022-01-03]
LDOPanels/BackPanel.3mf
245.0 x 210.0 x 3.00 mm
