camerony/VoronCustom/MiniASLGXerpaLiteMount/MiniASLGXerpaLite.step

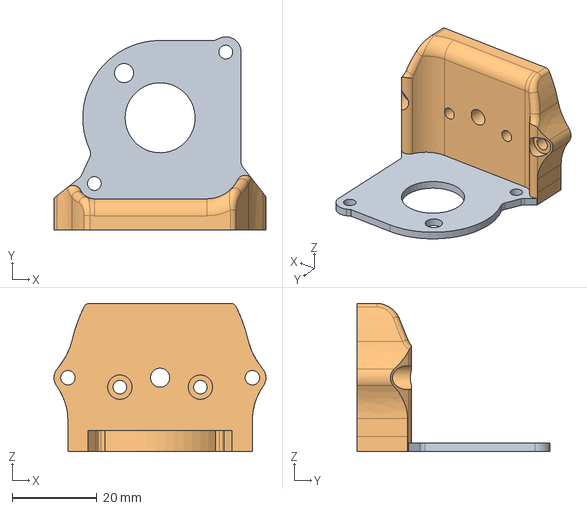
[picture p82: CAD file, 2022-03-10]
MiniASLGXerpaLiteMount/MiniASLGXerpaLite.step
50.0 x 45.6 x 35.0 mm
