camerony/VoronCustom/Tuning/VFA/VFATest_Setup.3mf

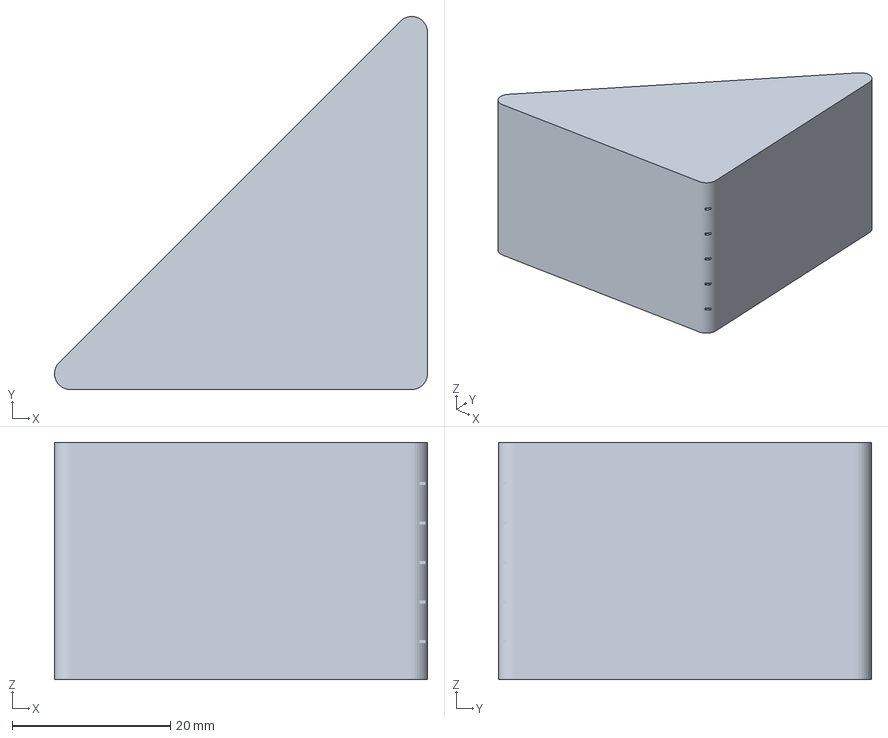
[picture p83: CAD file, 2022-03-28]
Tuning/VFA/VFATest_Setup.3mf
47.2 x 47.2 x 30.0 mm
