camerony/VoronCustom/v0.1_KirigamiLDOStealthFront/c_NeoPixel_Diffuser.stl

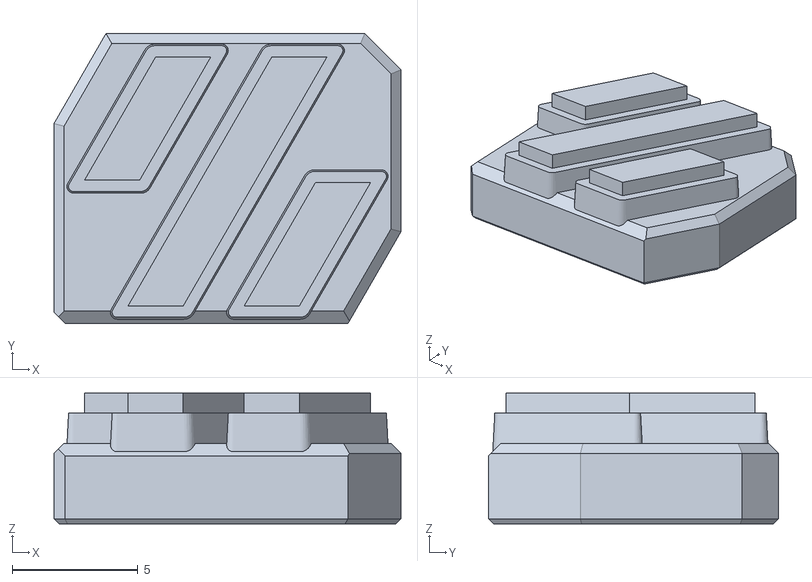
[picture p84: CAD file, 2022-09-03]
v0.1_KirigamiLDOStealthFront/c_NeoPixel_Diffuser.stl
13.8 x 11.5 x 5.20
