camerony/VoronCustom/v0.1_MiniAfterBlockHead/V01_MiniAfterBlockhead.3mf

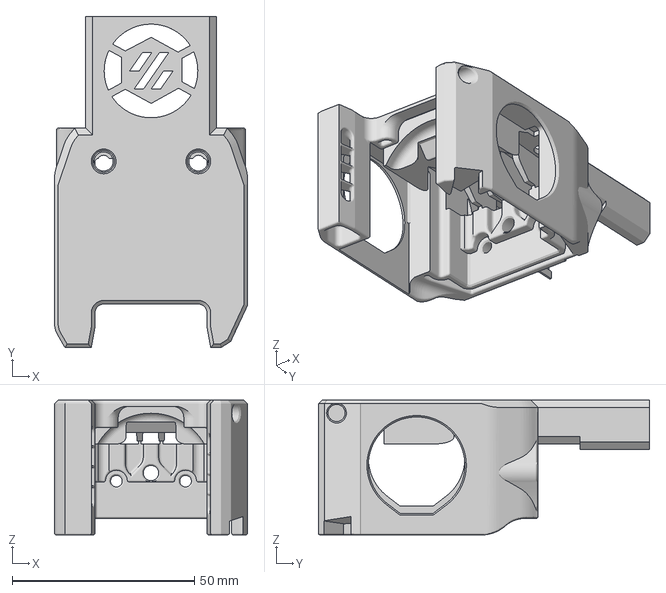
[picture p85: CAD file, 2022-03-19]
v0.1_MiniAfterBlockHead/V01_MiniAfterBlockhead.3mf
53.0 x 91.0 x 37.0 mm
