camerony/VoronCustom/v0.1_MiniAfterHybrid/V01_MiniAfterHybrid.step

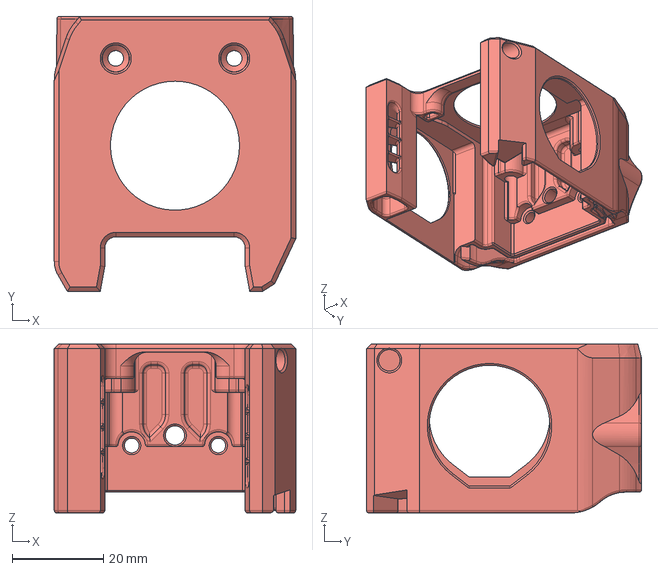
[picture p87: CAD file, 2022-03-06]
v0.1_MiniAfterHybrid/V01_MiniAfterHybrid.step
53.0 x 60.3 x 37.0 mm
