camerony/VoronCustom/V0.1_NoNut_X_Carriage/nonut_x_carriage_retainer_x1.stl

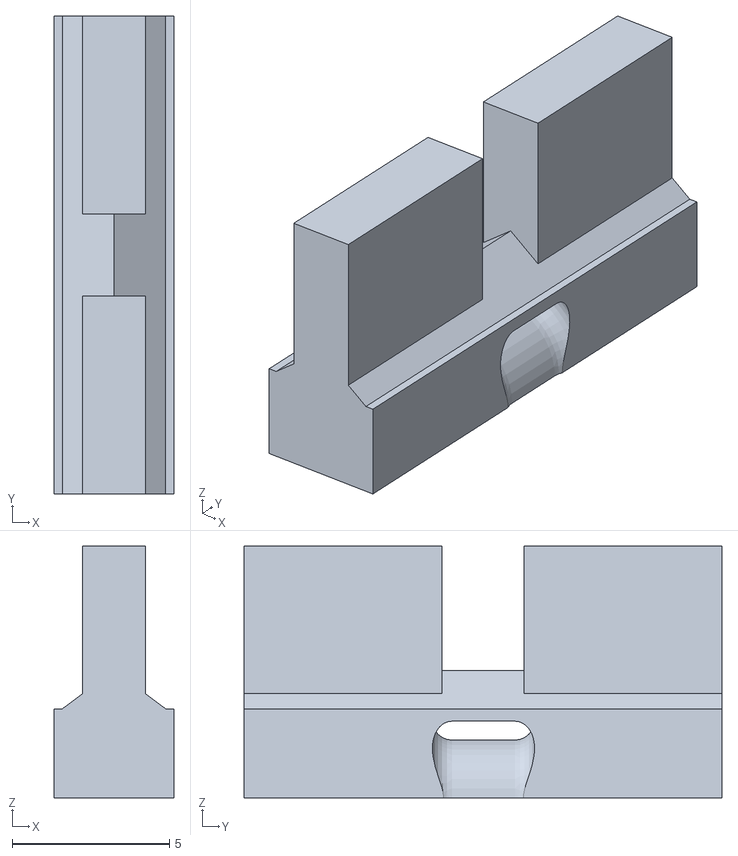
[picture p88: CAD file, 2022-01-22]
V0.1_NoNut_X_Carriage/nonut_x_carriage_retainer_x1.stl
3.80 x 15.2 x 8.00
