camerony/VoronCustom/V0.1_Raise_X_Axis_Extrusion_by_4mm/XY_Joint_Left_Upper_Raised4mm_x1.stl

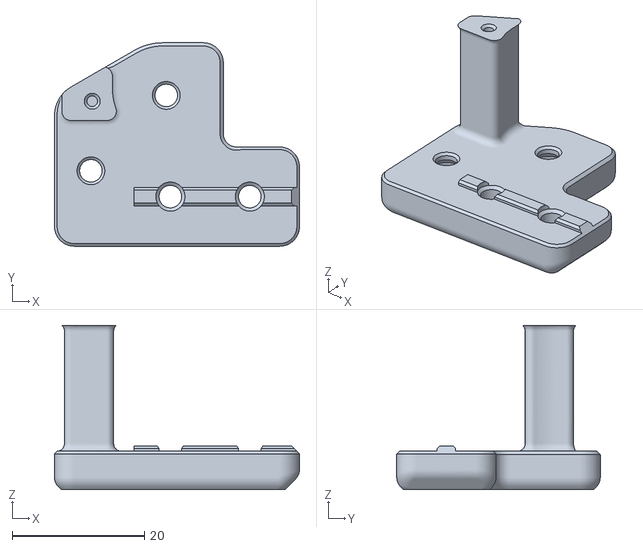
[picture p89: CAD file, 2022-01-16]
V0.1_Raise_X_Axis_Extrusion_by_4mm/XY_Joint_Left_Upper_Raised4mm_x1.stl
37.0 x 30.7 x 24.8
