camerony/VoronCustom/MiniASLGXerpaLiteMount/LGXHartKPCBStrainRelief.stl

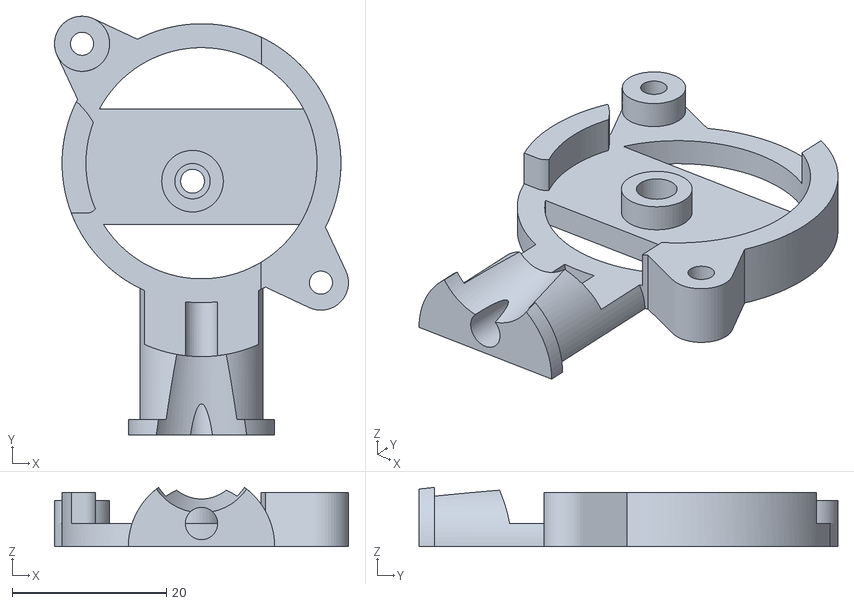
[picture p90: CAD file, 2022-02-09]
MiniASLGXerpaLiteMount/LGXHartKPCBStrainRelief.stl
38.2 x 54.3 x 7.69
