camerony/VoronCustom/v0.1_MiniAfterBlockHead/sherpa_mini_mid_flipped.step

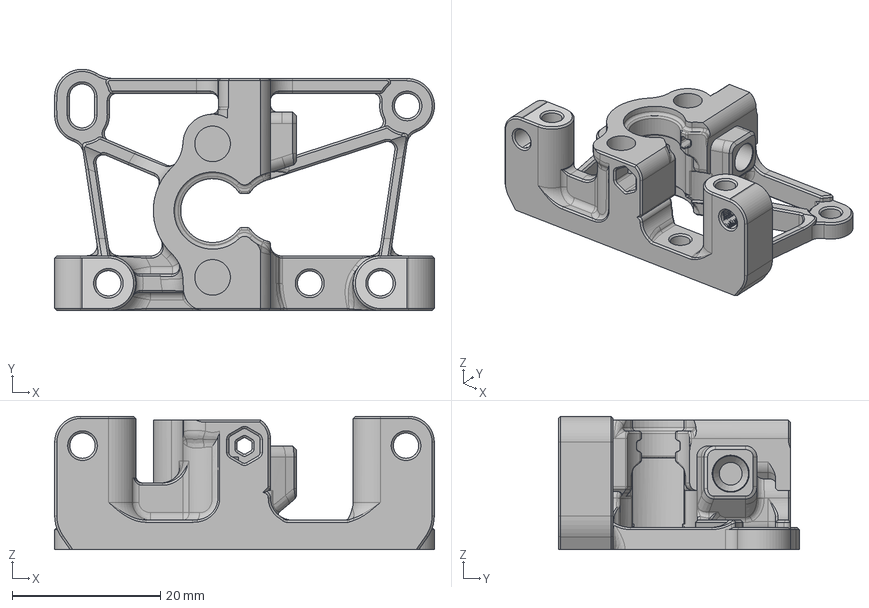
[picture p91: CAD file, 2022-03-19]
v0.1_MiniAfterBlockHead/sherpa_mini_mid_flipped.step
51.2 x 32.6 x 18.0 mm
