camerony/VoronCustom/v0.1_MiniAfterBlockHead/V2/hotendmountsV2/dragonfly_a.3mf

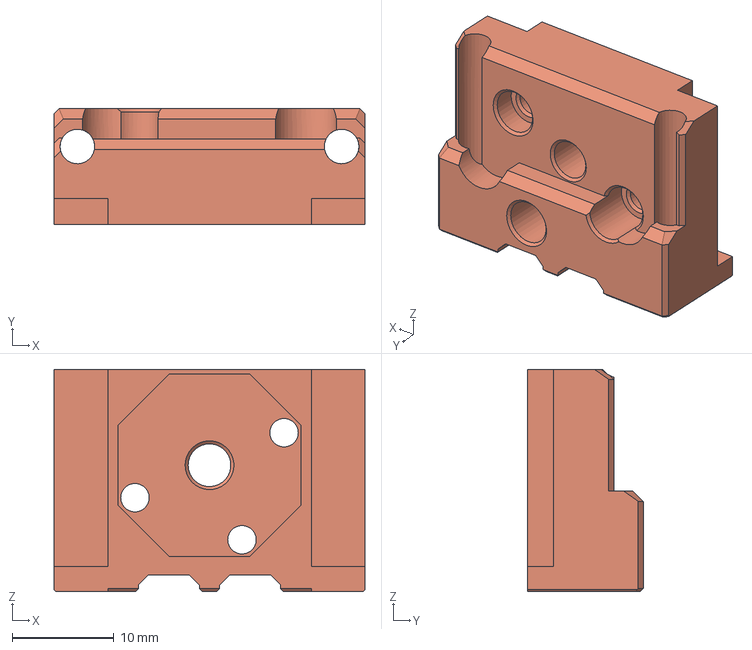
[picture p92: CAD file, 2022-04-21]
v0.1_MiniAfterBlockHead/V2/hotendmountsV2/dragonfly_a.3mf
30.6 x 11.4 x 21.9 mm
