camerony/VoronCustom/V0.1_NoNut_X_Carriage/nonut_x_carriage_x1.stl

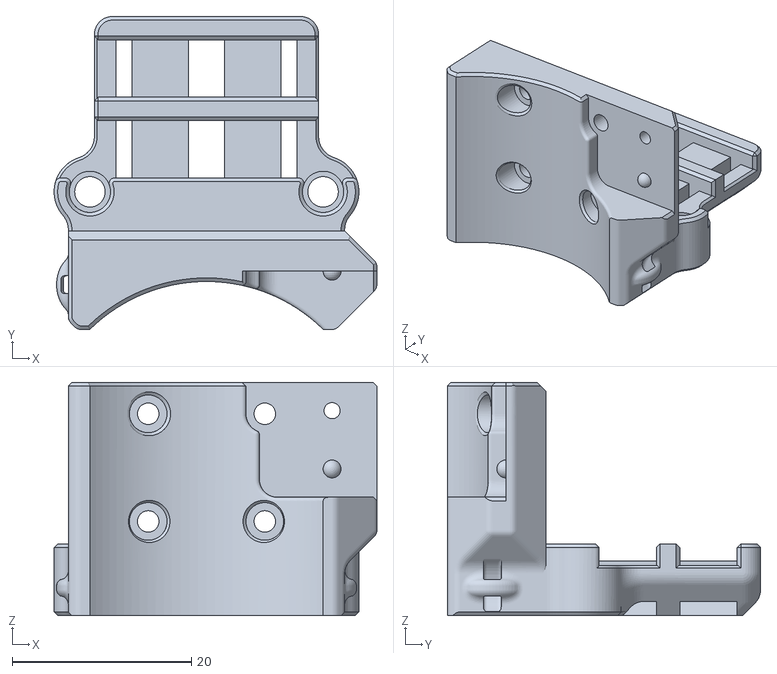
[picture p93: CAD file, 2022-01-21]
V0.1_NoNut_X_Carriage/nonut_x_carriage_x1.stl
36.0 x 34.9 x 26.0
