camerony/VoronCustom/MiniASLGXerpaLiteMount/MiniASLGXerpaLite-StrainRelief_Umb.stl

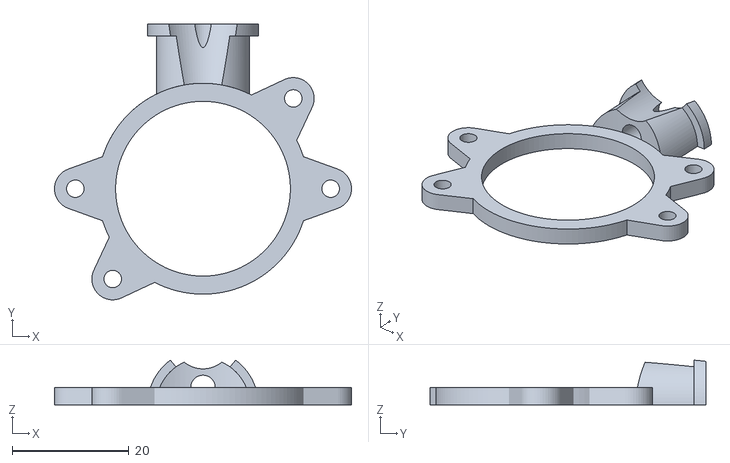
[picture p94: CAD file, 2022-01-30]
MiniASLGXerpaLiteMount/MiniASLGXerpaLite-StrainRelief_Umb.stl
51.0 x 47.3 x 7.69
