camerony/VoronCustom/v0.1_KirigamiLDOStealthFront/Bed_Front.stl

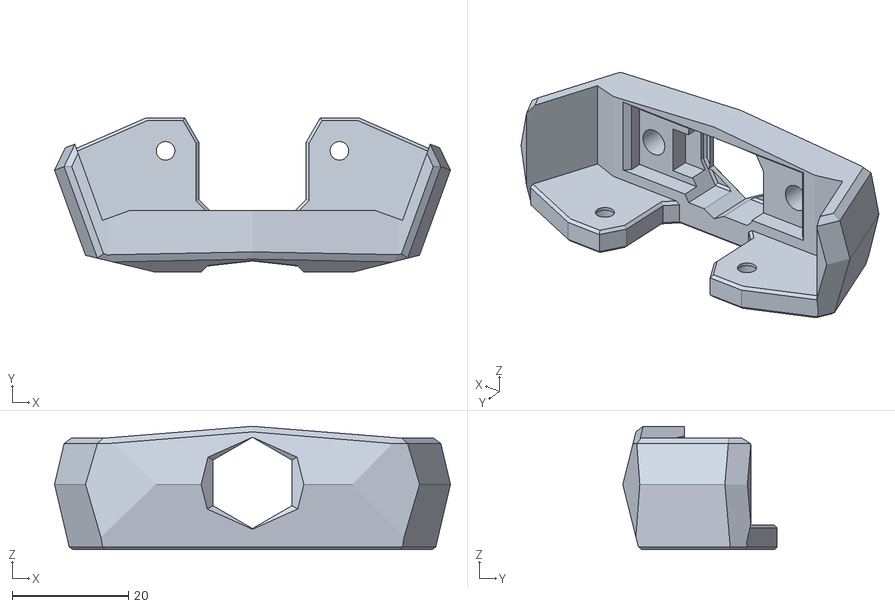
[picture p95: CAD file, 2022-09-03]
v0.1_KirigamiLDOStealthFront/Bed_Front.stl
68.2 x 26.6 x 21.2
