camerony/VoronCustom/v0.1_MiniAfterBlockHead/V01_MiniAfterBlockhead_XCarriage.step

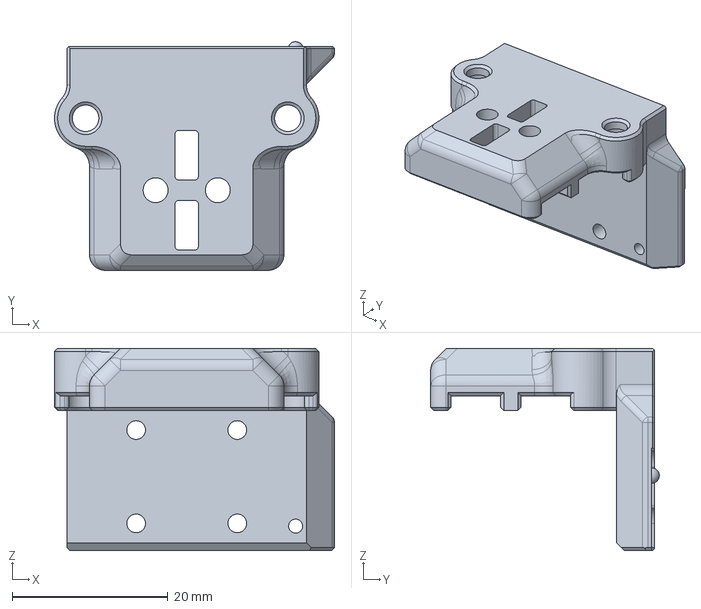
[picture p96: CAD file, 2022-03-06]
v0.1_MiniAfterBlockHead/V01_MiniAfterBlockhead_XCarriage.step
36.0 x 29.4 x 26.0 mm
cowling_universal taller
X_Carriage
