camerony/VoronCustom/V0.1_NoNut_X_Carriage/nonut_x_carriage_retainer_hard_x1.stl

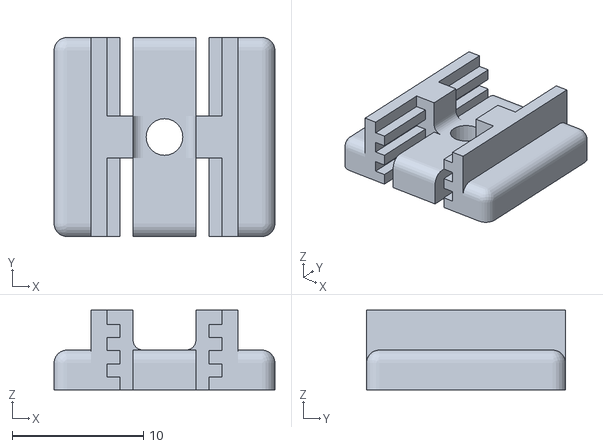
[picture p97: CAD file, 2022-01-18]
V0.1_NoNut_X_Carriage/nonut_x_carriage_retainer_hard_x1.stl
16.9 x 15.2 x 6.10
