camerony/VoronCustom/MiniASLGXerpaLiteMount/Strain_Relief_Spacers_x2.3mf

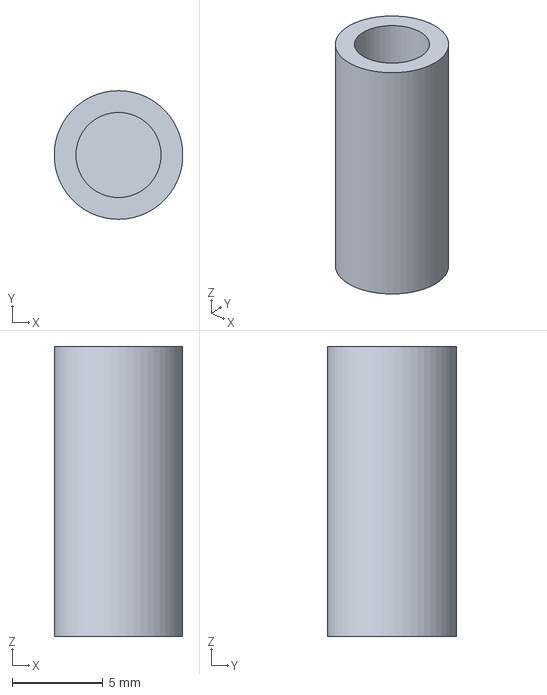
[picture p98: CAD file, 2022-01-03]
MiniASLGXerpaLiteMount/Strain_Relief_Spacers_x2.3mf
7.09 x 7.10 x 16.0 mm
