camerony/VoronCustom/V0.1_Raise_X_Axis_Extrusion_by_4mm/XY_Joints_Raised4mm_x1.3mf

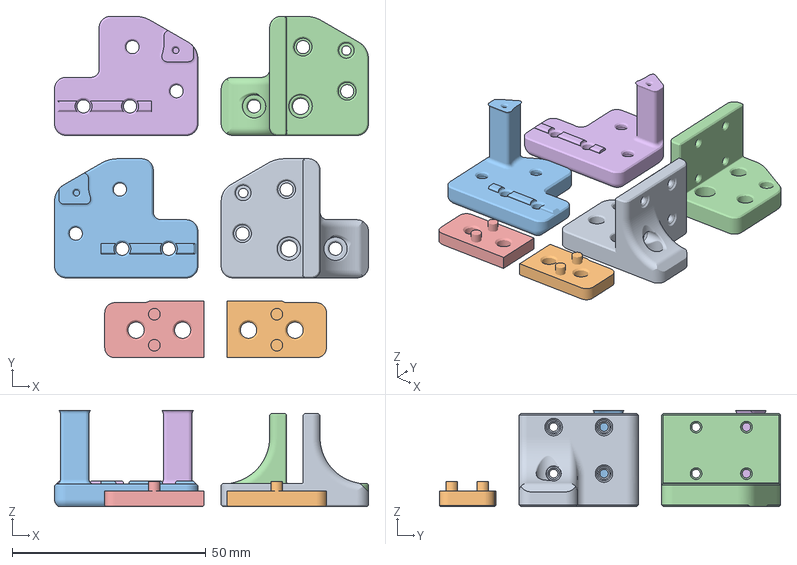
[picture p99: CAD file, 2022-01-16]
V0.1_Raise_X_Axis_Extrusion_by_4mm/XY_Joints_Raised4mm_x1.3mf
81.0 x 88.1 x 24.8 mm
XY_Joint_Left_Lower_Raised4mm_x1
XY_Joint_Left_Mid_Raised4mm_x1
XY_Joint_Left_Upper_Raised4mm_x1
XY_Joint_Right_Lower_Raised4mm_x1
XY_Joint_Right_Mid_Raised4mm_x1
XY_Joint_Right_Upper_Raised4mm_x1
