camerony/VoronCustom/MiniASLGXerpaLiteMount/MiniASLGXerpaLite-StrainRelief.3mf

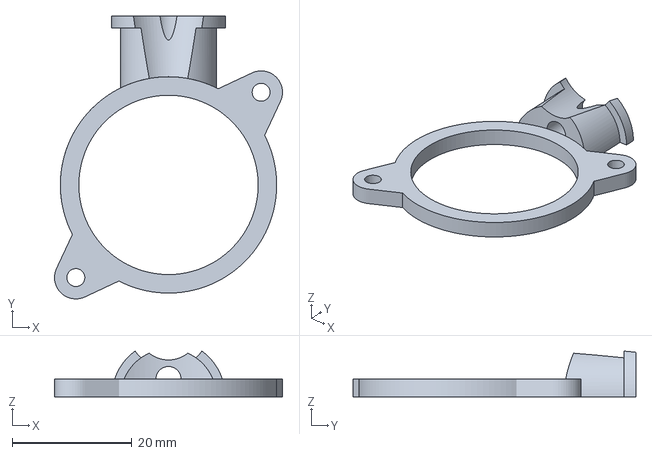
[picture p100: CAD file, 2022-01-03]
MiniASLGXerpaLiteMount/MiniASLGXerpaLite-StrainRelief.3mf
38.2 x 47.3 x 7.69 mm
