camerony/VoronCustom/(list of files, cad)

Other CAD files:
Tuning/BeltTensionEqualizer/BeltTension.stl
Tuning/VFA/VFA_Model_SS.3mf
v0.1_KirigamiCarriageSpacer/KirigamiCarriageSpacer.step
v0.1_MiniAfterBlockHead/V01_MiniAfterBlockhead_XCarriage_MGN9.step
V0.1_Raise_X_Axis_Extrusion_by_4mm/XY_Joint_Right_Mid_Raised4mm_x1.stl
V0.1_XY_Joint_Beefy/XY_Joint_Left_Beefy_Lower_x1.step
v0.1_KirigamiLDOStealthFront/v0.1_KirigamiLDOStealthFront.3mf
V0.1_Raise_X_Axis_Extrusion_by_4mm/XY_Joint_Right_Upper_Raised4mm_x1.stl
V0.1_Raise_X_Axis_Extrusion_by_4mm/XY_Joint_Right_Lower_Raised4mm_x1.stl
V0.1_Raise_X_Axis_Extrusion_by_4mm/XY_Joint_Left_Lower_Raised4mm_x1.stl
7x7CableChain/7x7cablechain.3mf
7x7CableChain/7x7cablechain.stl
LDOPanels/BackPanel.stl
LDOPanels/LDOBackPanel.f3d
LDOPanels/LDOBackPanel.stl
LDOPanels/LDODeckPanel.f3d
LDOPanels/LDODeckPanelFull.stl
LDOSBCW2MountCover/LDOSBCW2Cover.stl
LDOSBCW2MountCover/LDOSBCW2Mount.stl
MiniASLGXerpaLiteMount/MiniASLGXerpaLite-Cover.3mf
MiniASLGXerpaLiteMount/MiniASLGXerpaLite-Cover.step
MiniASLGXerpaLiteMount/MiniASLGXerpaLite-Cover.stl
MiniASLGXerpaLiteMount/MiniASLGXerpaLite-CoverV2.3mf
MiniASLGXerpaLiteMount/MiniASLGXerpaLite-CoverV2.stl
MiniASLGXerpaLiteMount/MiniASLGXerpaLite-StrainRelief.stl
MiniASLGXerpaLiteMount/MiniASLGXerpaLite.3mf
MiniASLGXerpaLiteMount/MiniASLGXerpaLite.stl
MiniASLGXerpaLiteMount/Strain_Relief_Spacers_x2.stl
NeoPixelSolderingTool/NeoPixelSolderingTool.stl
V0.1_BedTransfer/V0.1_bed_transfer.stl
V0.1_Display/Housing_Rear_M2_10_x1.3mf
V0.1_Display/Housing_Rear_M2_10_x1.stl
V0.1_Display/[a]_Knob_Spacer_x1.3mf
V0.1_Display/[a]_Knob_Spacer_x1.stl
V0.1_Dual_X_Rail_Carriage/no_nut_dual_x_carriage.stl
V0.1_Dual_X_Rail_Carriage/no_nut_retainer.stl
V0.1_Dual_X_Rail_Carriage/no_nut_tool.stl
V0.1_Raise_X_Axis_Extrusion_by_4mm/XY_Joints_Raised4mm_x1.stl
V0.1_XY_Joint_Beefy/XY_Joint_Left_Beefy_Lower_x1.3mf
V0.1_XY_Joint_Beefy/XY_Joint_Left_Beefy_Lower_x1.stl
V0.1_XY_Joint_Beefy/XY_Joint_Right_Beefy_Lower_x1.3mf
V0.1_XY_Joint_Beefy/XY_Joint_Right_Beefy_Lower_x1.stl
V0.1_Z_Chain_Mount/V01_Z_Chain_Mount.stl
V0.1_Z_Jiggy/V01_Z_Jiggy.3mf
V0.1_Z_Jiggy/V01_Z_Jiggy.stl
v0.1_KirigamiCarriageSpacer/KirigamiCarriageSpacer_x2.stl
v0.1_MiniAfterBlockHead/V01_MiniAfterBlockhead.stl
v0.1_MiniAfterBlockHead/V01_MiniAfterBlockhead_XCarriage.3mf
v0.1_MiniAfterBlockHead/V01_MiniAfterBlockhead_XCarriage.stl
v0.1_MiniAfterBlockHead/V01_MiniAfterBlockhead_XCarriage_MGN9.3mf
v0.1_MiniAfterBlockHead/V01_MiniAfterBlockhead_XCarriage_MGN9.stl
v0.1_MiniAfterBlockHead/V2/V01_MiniAfterBlockheadv2.stl
v0.1_MiniAfterBlockHead/sherpa_mini_mid_flipped.3mf
v0.1_MiniAfterBlockHead/sherpa_mini_mid_flipped.stl
v0.1_MiniAfterHybrid/Orbiter2Mount.3mf
v0.1_MiniAfterHybrid/Orbiter2Mount.stl
v0.1_MiniAfterHybrid/V01_MiniAfterHybrid.3mf
v0.1_MiniAfterHybrid/V01_MiniAfterHybrid.stl
v0.1_Tensioner_Knob_Indicator/Tensioner_Knob_Marks.3mf
v0.1_Tensioner_Knob_Indicator/Tensioner_Knob_Marks.stl
