camerony/VoronCustom/NeoPixelSolderingTool/README.md

# Neopixel Soldering Tool

Use a piece of double side tape on the bottom to keep it in place.

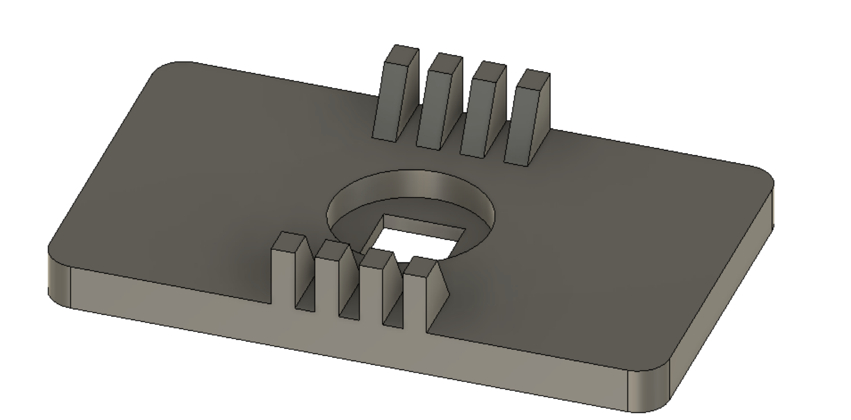
[picture p101: NeoPixelSolderingTool/images/cad.png]
   
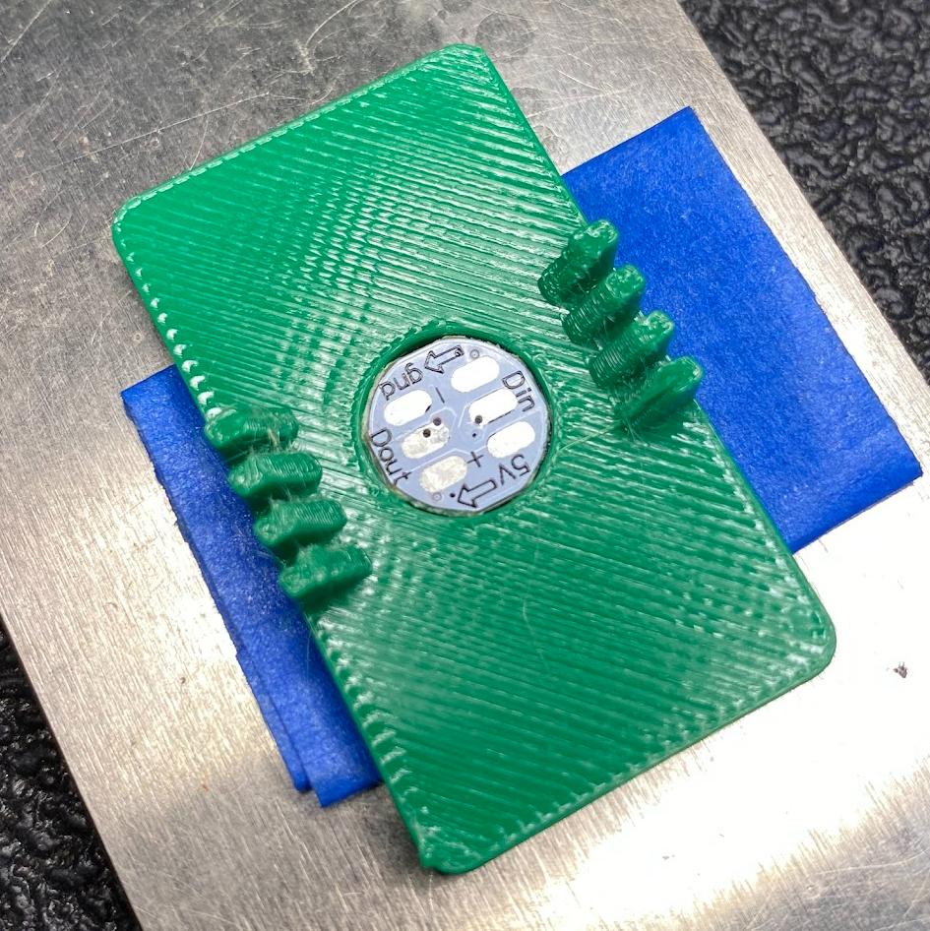
[picture p102: NeoPixelSolderingTool/images/photo.png]
