camerony/VoronCustom/LDOSBCW2MountCover/images/Step0.png

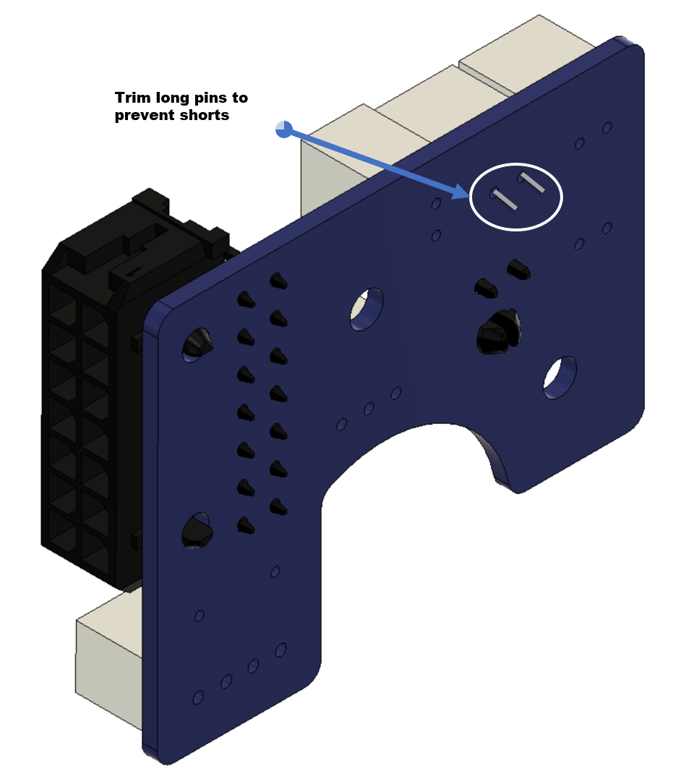
LDOSBCW2MountCover/images/Step0.png
