camerony/VoronCustom/LDOSBCW2MountCover/images/Step2.png

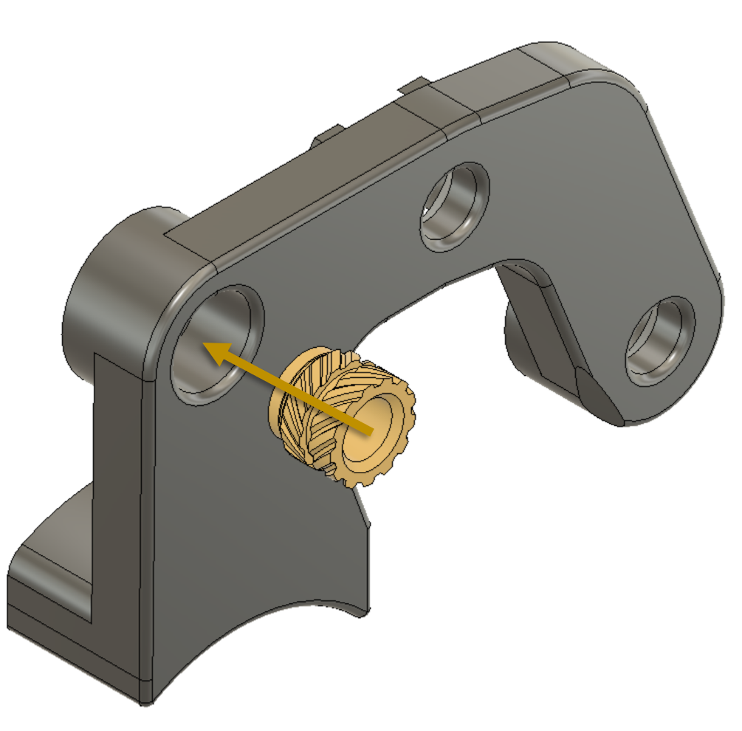
LDOSBCW2MountCover/images/Step2.png
