camerony/VoronCustom/LDOSBCW2MountCover/images/Step3.png

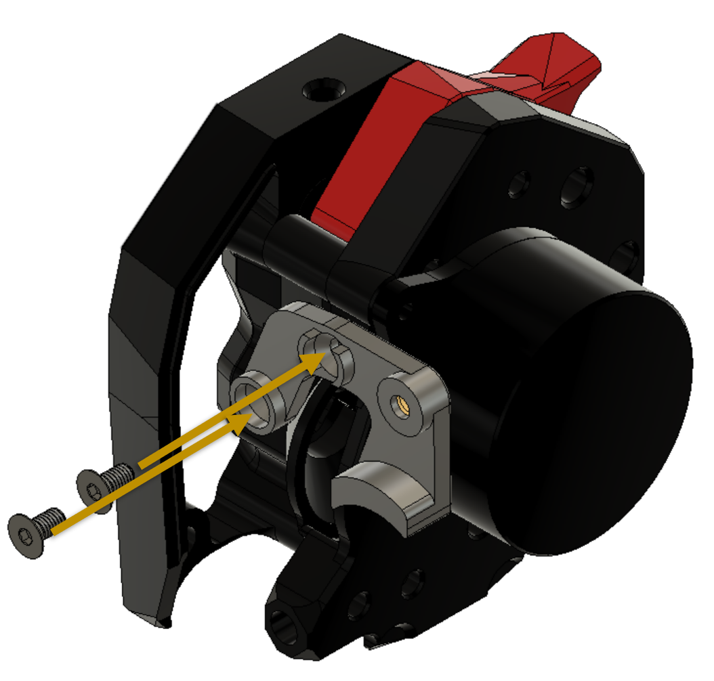
LDOSBCW2MountCover/images/Step3.png
