camerony/VoronCustom/LDOSBCW2MountCover/images/Step4.png

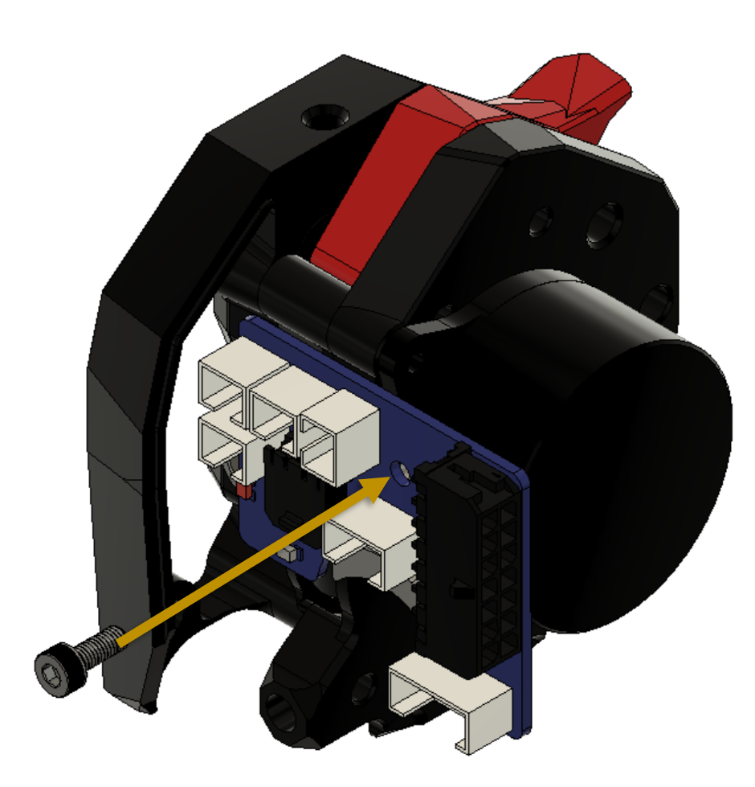
LDOSBCW2MountCover/images/Step4.png
