camerony/VoronCustom/LDOSBCW2MountCover/images/Step5.png

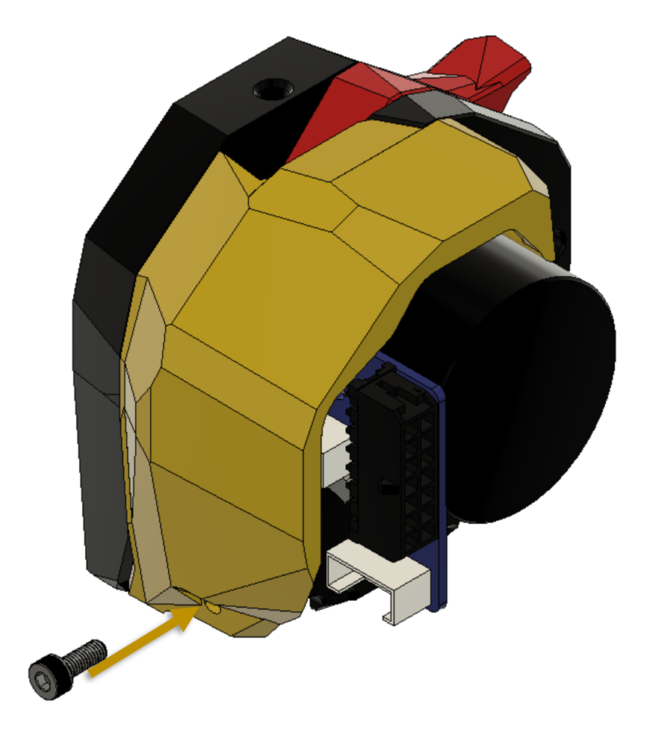
LDOSBCW2MountCover/images/Step5.png
