camerony/VoronCustom/V0.1_NoNut_X_Carriage/images/installed.png

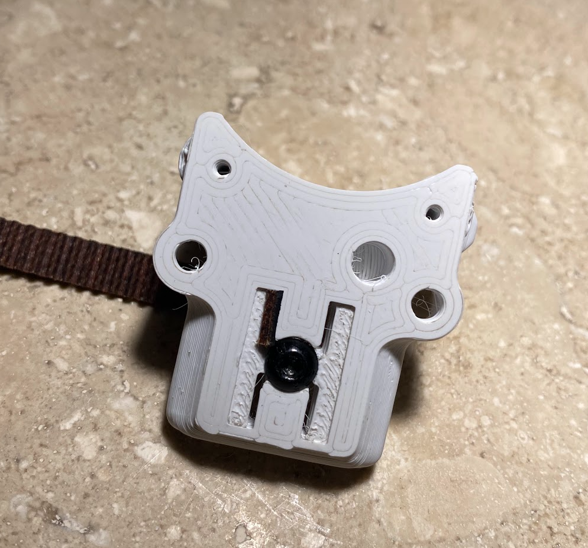
V0.1_NoNut_X_Carriage/images/installed.png
