camerony/VoronCustom/Tuning/BeltTensionEqualizer/README.md

# Belt Tension Equalizer V0.1

Use to check if both belt have approximately the same tension.
This should not be use as an indicator for the right tension, you should tension one belt then use this to equalize them.

You can slide the toolhead left for more tension, if needed.

Print using any filament.  :D

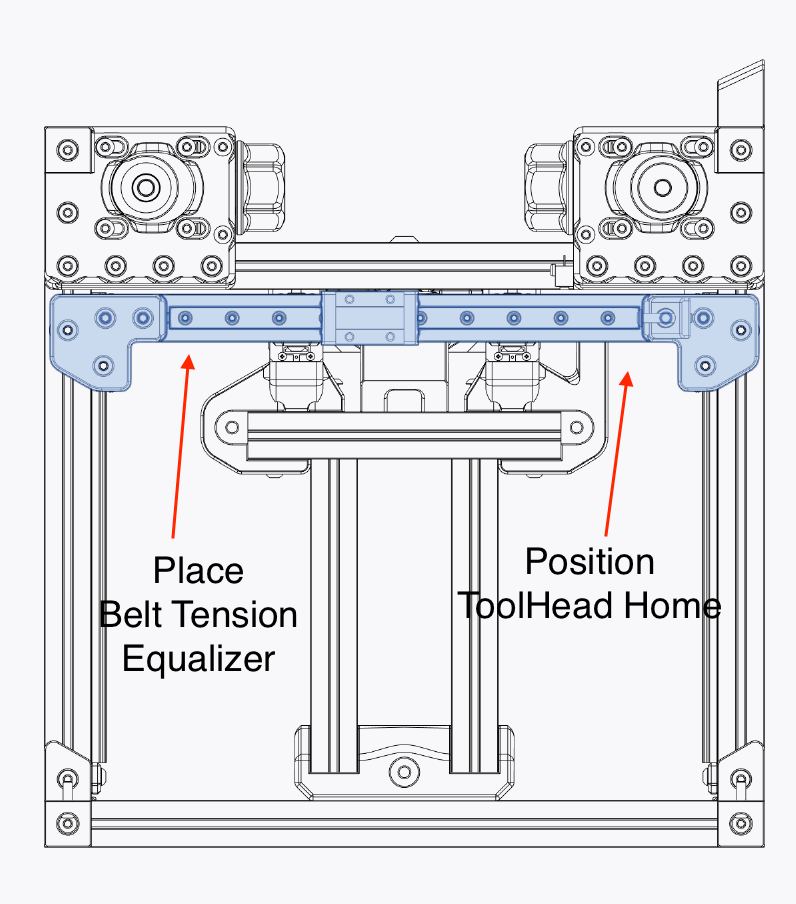
[picture p110: Tuning/BeltTensionEqualizer/images/BeltTensionEqualizer.png]
