camerony/VoronCustom/(commit log)

2021-11-19 LDO Panels for V01
    [LDOBackPanel.3mf, LDOBackPanel.f3d, LDODeckPanel.f3d, LDODeckPanelFull.3mf]
2021-11-19 Fixed LDO Orientation
    [LDOBackPanel.3mf, LDOBackPanel.f3d]
2022-01-01 MiniABLHXerpaLite
    Drop In Replacement for MiniSherpa 2x M3x12 and 2x M3x8
    [MiniABLGXerpaLite.3mf, MiniABLGXerpaLite.stl]
2022-01-05 Updates & Cover
    [MiniASLGXerpaLite-Cover.stl, MiniASLGXerpaLite-StrainRelief.3mf, MiniASLGXerpaLite-StrainRelief.stl, MiniASLGXerpaLite.3mf, MiniASLGXerpaLite.stl, Strain_Relief_Spacers_x2.3mf, Strain_Relief_Spacers_x2.stl]
2022-01-12 new design in the works
    [x_carriage_pressfit_belt_noscoop_x1.stl, x_carriage_pressfit_belt_retainer.3mf, x_carriage_pressfit_belt_retainer_x2.stl, x_carriage_pressfit_belt_x1.stl]
2022-01-16 Updated files
    [README.stl, XY_Joint_Left_Mid_Raised4mm_x1.stl]
2022-01-17 No Nuts
    [nonut_x_carriage_removal_tool_x1.stl, nonut_x_carriage_retainer_x1.stl, nonut_x_carriage_x1.stl]
2022-01-19 Plate Probe
2022-01-19 added recommendation for cleaning the nozzle tip
2022-01-20 Nozzy Probe
2022-01-21 New Version
    [nonut_x_carriage_belt_guide_x1.stl, nonut_x_carriage_removal_tool_x1.stl, nonut_x_carriage_retainer_hard_x1.stl, nonut_x_carriage_retainer_x1.stl, nonut_x_carriage_x1.stl]
2022-01-22 adjust clearance
    [nonut_x_carriage_belt_guide_x1.stl, nonut_x_carriage_removal_tool_x1.stl, nonut_x_carriage_retainer_x1.stl]
2022-01-30 Bed Transfer Tool for V0.1
    [MiniASLGXerpaLite-StrainRelief_Umb.stl, V0.1_bed_transfer.stl]
2022-03-04 Z-Chain Mount
    [V01_Z_Chain_Mount.stl]
2022-03-06 Added CAD
    [V01_MiniAfterHybrid.step, V01_MiniAfterHybrid_XCarriage.step, mount_dragonfly.3mf, mount_dragonfly.stl]
2022-03-10 Steps Files
    [MiniASLGXerpaLite-Cover.step, MiniASLGXerpaLite.step, V01_Z_Chain_Mount.step]
2022-03-17 CAD Update
2022-03-18 Z Alignment tool
    [V01_Z_Jiggy.3mf, V01_Z_Jiggy.step, V01_Z_Jiggy.stl]
2022-03-21 Updated Cover, more printable
    [MiniASLGXerpaLite-CoverV2.3mf, MiniASLGXerpaLite-CoverV2.step, MiniASLGXerpaLite-CoverV2.stl]
2022-03-22 Tensioner Knob
    [Tensioner_Knob_Marks.step, Tensioner_Knob_Marks.stl]
2022-03-26 MGN9 x-carriage
    [V01_MiniAfterBlockhead_XCarriage_MGN9.3mf, V01_MiniAfterBlockhead_XCarriage_MGN9.step, V01_MiniAfterBlockhead_XCarriage_MGN9.stl]
2022-03-26 XY Beefy Joints
    [XY_Joint_Left_Beefy_Lower_x1.3mf, XY_Joint_Left_Beefy_Lower_x1.step, XY_Joint_Left_Beefy_Lower_x1.stl, XY_Joint_Right_Beefy_Lower_x1.3mf, XY_Joint_Right_Beefy_Lower_x1.step, XY_Joint_Right_Beefy_Lower_x1.stl]
2022-03-28 VFA Test Prints
    [VFATest_Setup.3mf, VFA_Model_SS.3mf, VFA_Model_SS_Thick.3mf]
2022-03-31 Added Revo Micro
    [V01_MiniAfterHybridRevoMicro.3mf, V01_MountRevoMicro.3mf]
2022-04-02 Updated
    With Zip Tie loop and wire channel
    [V01_MiniAfterHybrid.3mf, V01_MiniAfterHybrid.stl, V01_MiniAfterHybridRevoMicro.3mf]
2022-04-14 Neopixel Tool
    [NeoPixelSolderingTool.stl]
2022-04-29 Fix formatting for Z chain mount README
2022-05-16 Kirigami Spacer
    [KirigamiCarriageSpacer.step, KirigamiCarriageSpacer_x2.3mf, KirigamiCarriageSpacer_x2.stl]
2022-08-19 LDO SB+CW2 Mount and Cover
    [LDOSBCW2Cover.step, LDOSBCW2Cover.stl, LDOSBCW2Mount.step, LDOSBCW2Mount.stl, LDOSBCW2MountCover.3mf]
2022-09-03 LDO Stealth Bed Front
    [Bed_Front.stl, LDO_Stealth_Bed_Front.step, b_NeoPixel_Diffuser_Mask.stl, c_NeoPixel_Diffuser.stl, v0.1_KirigamiLDOStealthFront.3mf]
