camerony/VoronCustom/Tuning/BeltTensionEqualizer/BeltTensionEqualizer.JPG

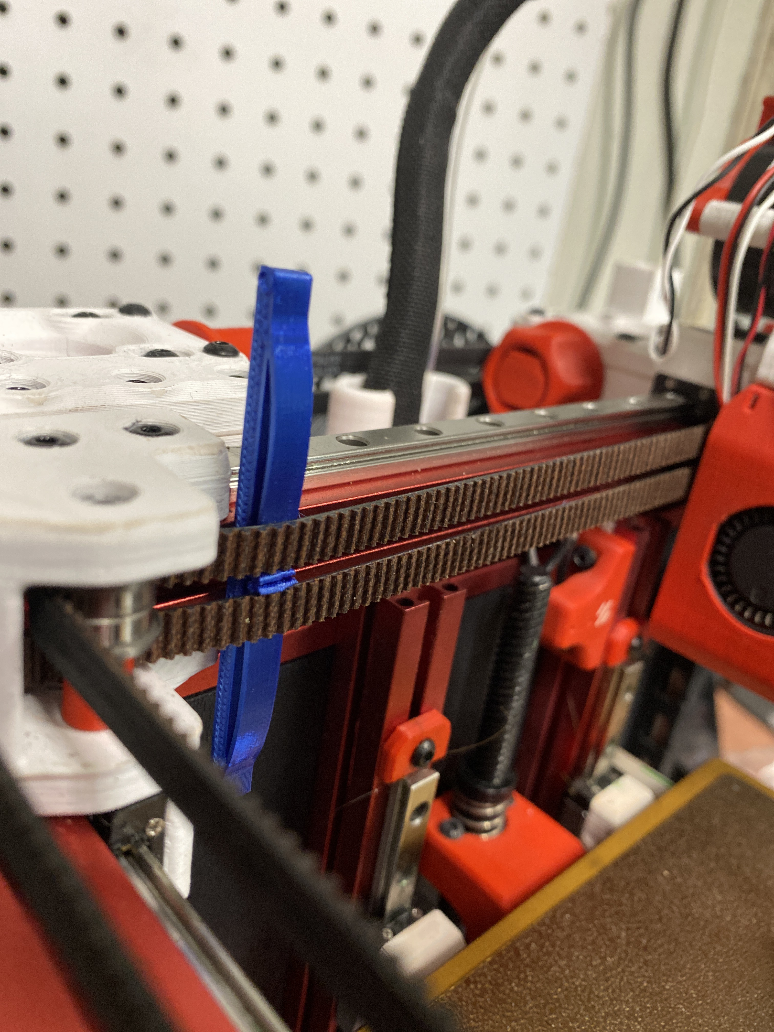
[picture p111: Tuning/BeltTensionEqualizer/images/BeltTensionEqualizer.jpg]
Tuning/BeltTensionEqualizer/BeltTensionEqualizer.JPG
